QUT-Motorsport/QUTMS_Shutdown/hardware/CAD/219-3MSTR/219-3poles.stp

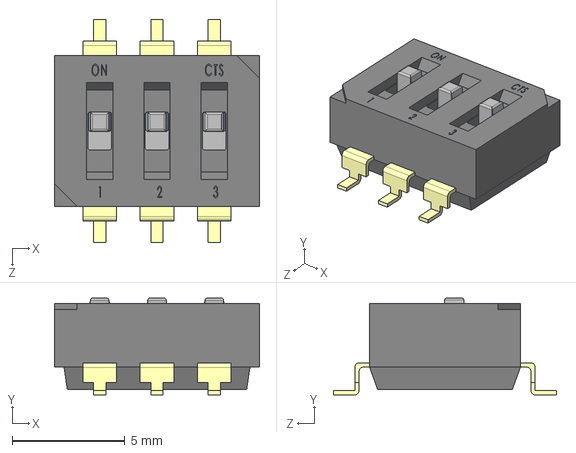
[picture p1: CAD file, 2021-01-13]
hardware/CAD/219-3MSTR/219-3poles.stp
9.09 x 4.30 x 9.91 mm
