QUT-Motorsport/QUTMS_Shutdown/hardware/CAD/6-Pin Header/pin_header_a-sl254-ea-z06mp1.stp

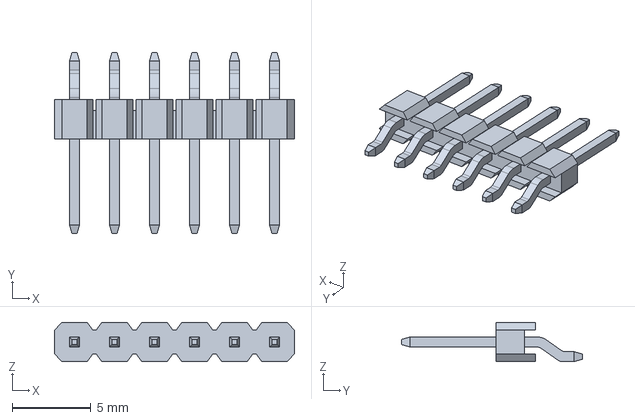
[picture p2: CAD file, 2021-01-13]
hardware/CAD/6-Pin Header/pin_header_a-sl254-ea-z06mp1.stp
15.2 x 11.5 x 2.50 mm
