QUT-Motorsport/QUTMS_Shutdown/hardware/CAD/CVS-03TB/CVS-03TB.stp

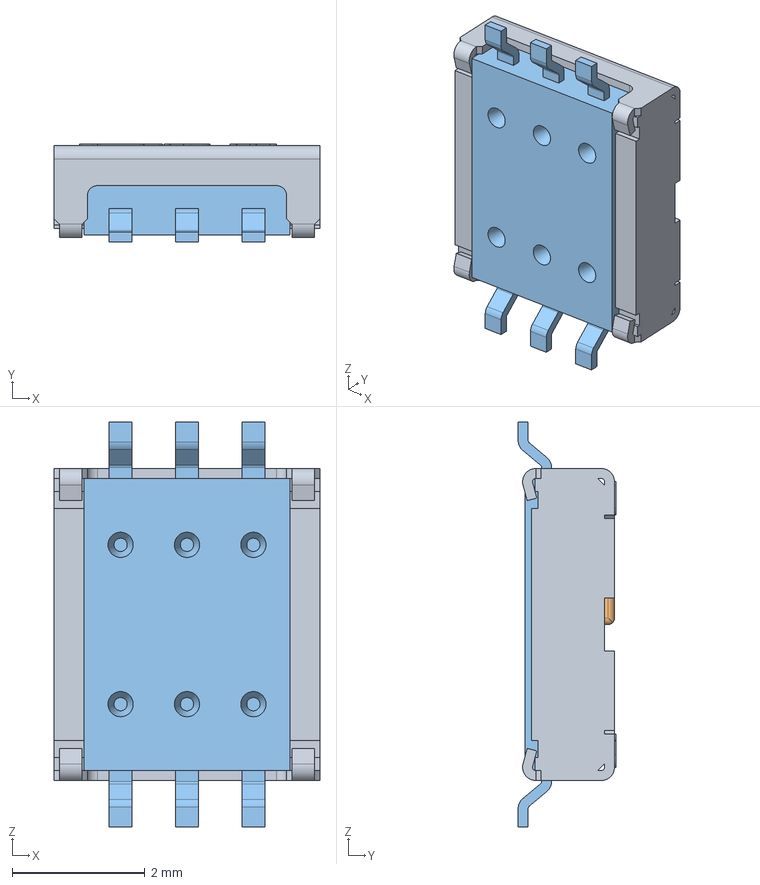
[picture p3: CAD file, 2021-01-13]
hardware/CAD/CVS-03TB/CVS-03TB.stp
4.00 x 1.47 x 6.10 mm
_CVS-03-body
_CVS-slider x 3
_CVS-B4-terminal
