QUT-Motorsport/QUTMS_Shutdown/hardware/CAD/LY4-0-DC12/LY4.SLDPRT

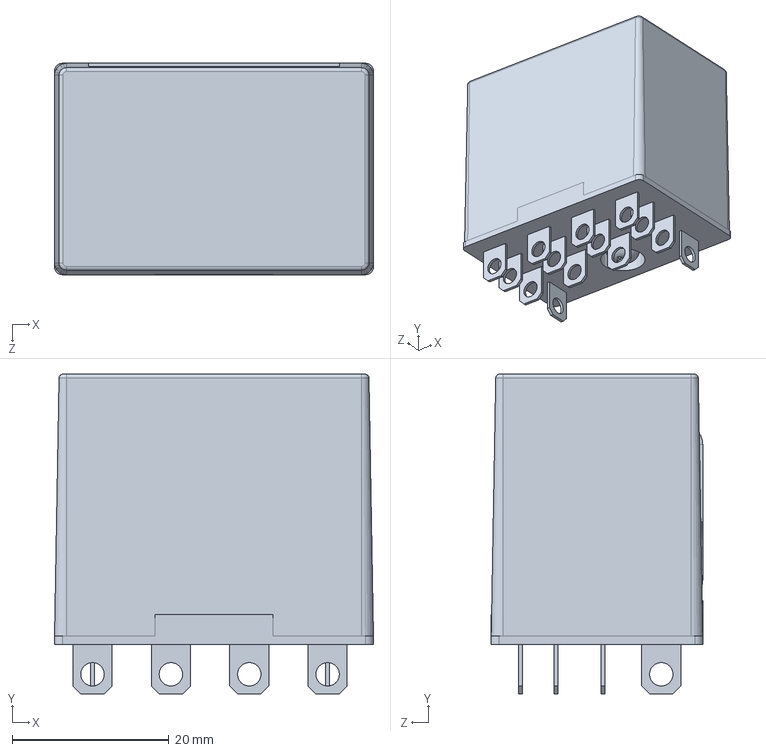
[picture p4: CAD file, 2021-01-13]
hardware/CAD/LY4-0-DC12/LY4.SLDPRT
40.7 x 40.8 x 27.0 mm
