QUT-Motorsport/QUTMS_Shutdown/hardware/CAD/MX120G/143626.stp

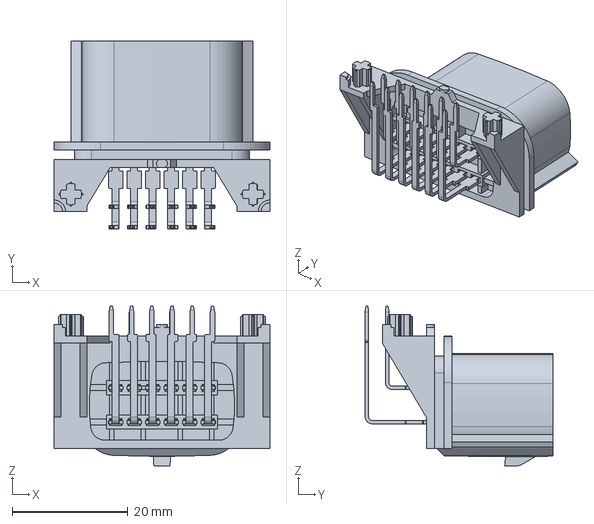
[picture p5: CAD file, 2021-01-13]
hardware/CAD/MX120G/143626.stp
37.4 x 32.5 x 27.6 mm
