QUT-Motorsport/QUTMS_Shutdown/hardware/QUTMS-SHDN-V00/QUTMS-SHDN-V00.pdf

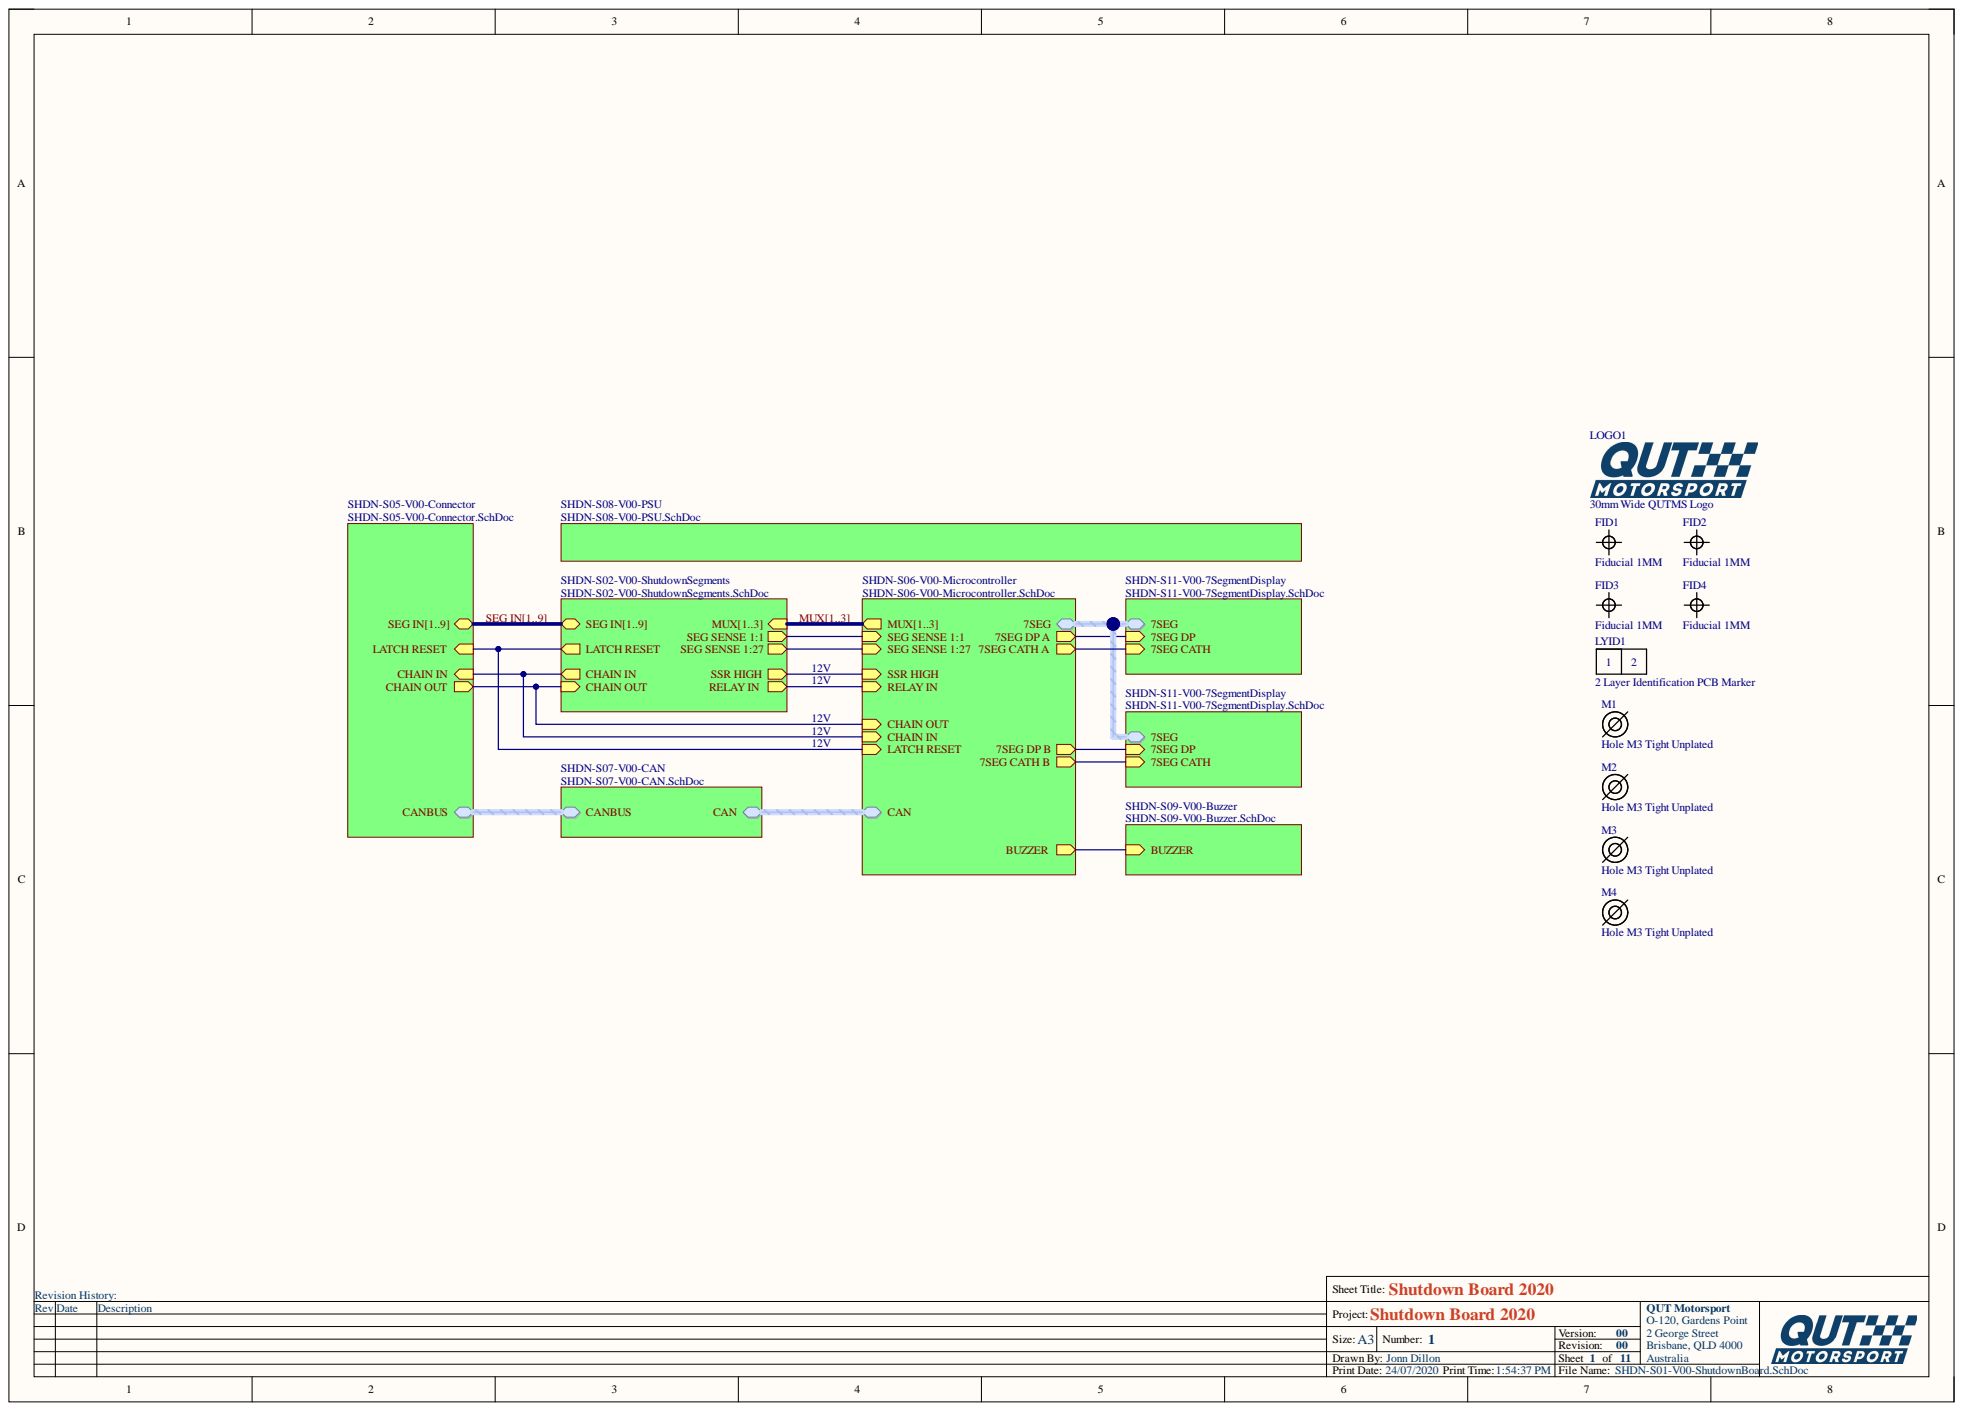
[picture p10: page 1]

C H A IN O UT R E LAY I N | 12V

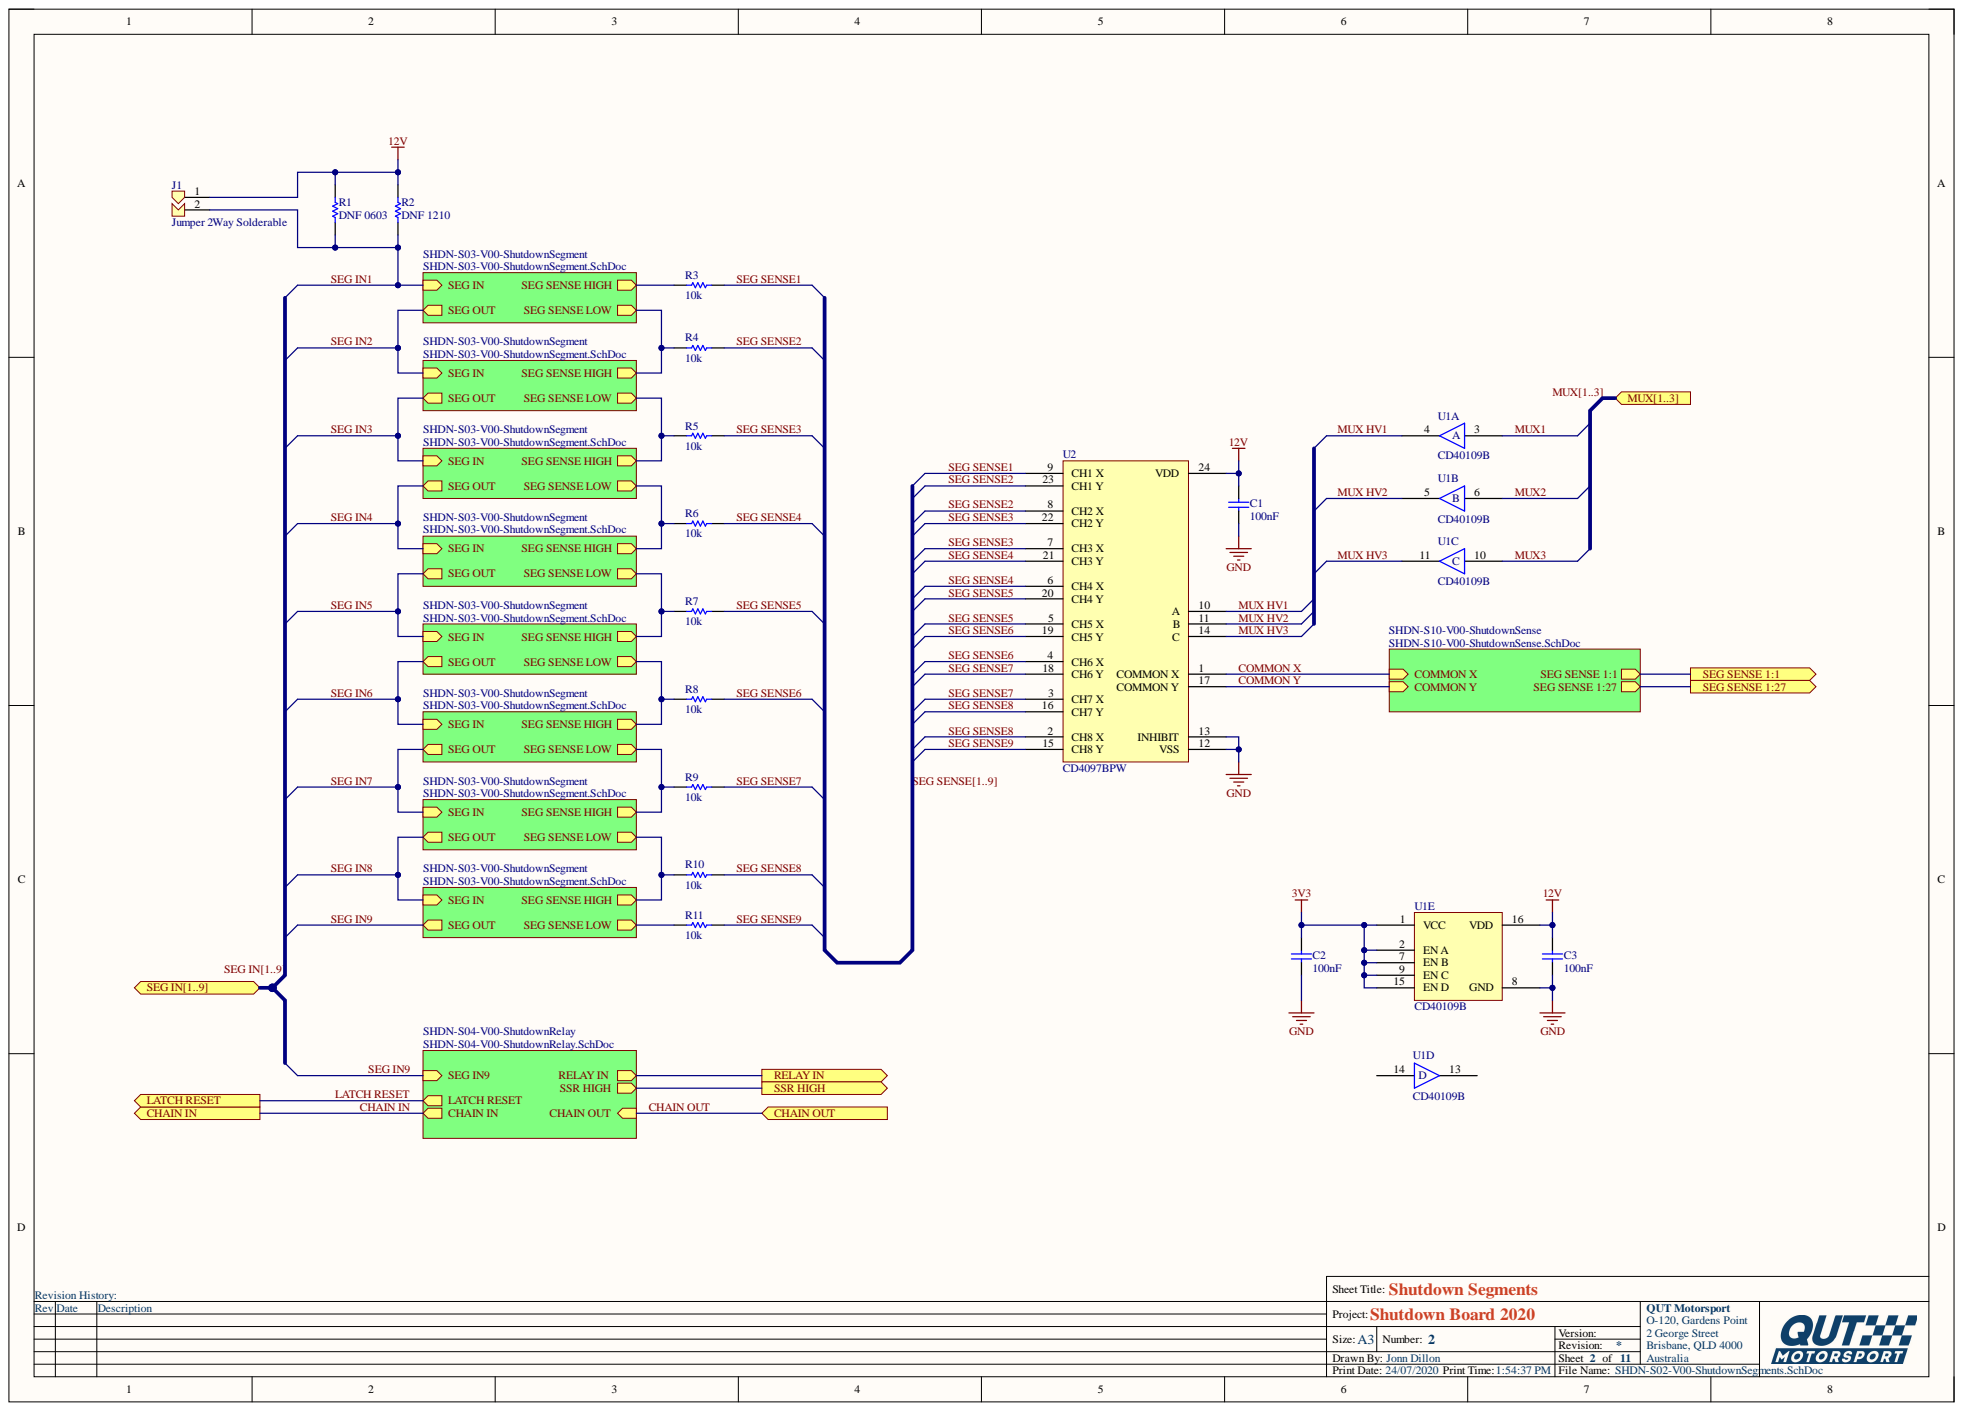
[picture p11: page 2]

Sheet Title: Shutdown Segments
Shutdown Board 2020

Drawn By: Jonn Dillon

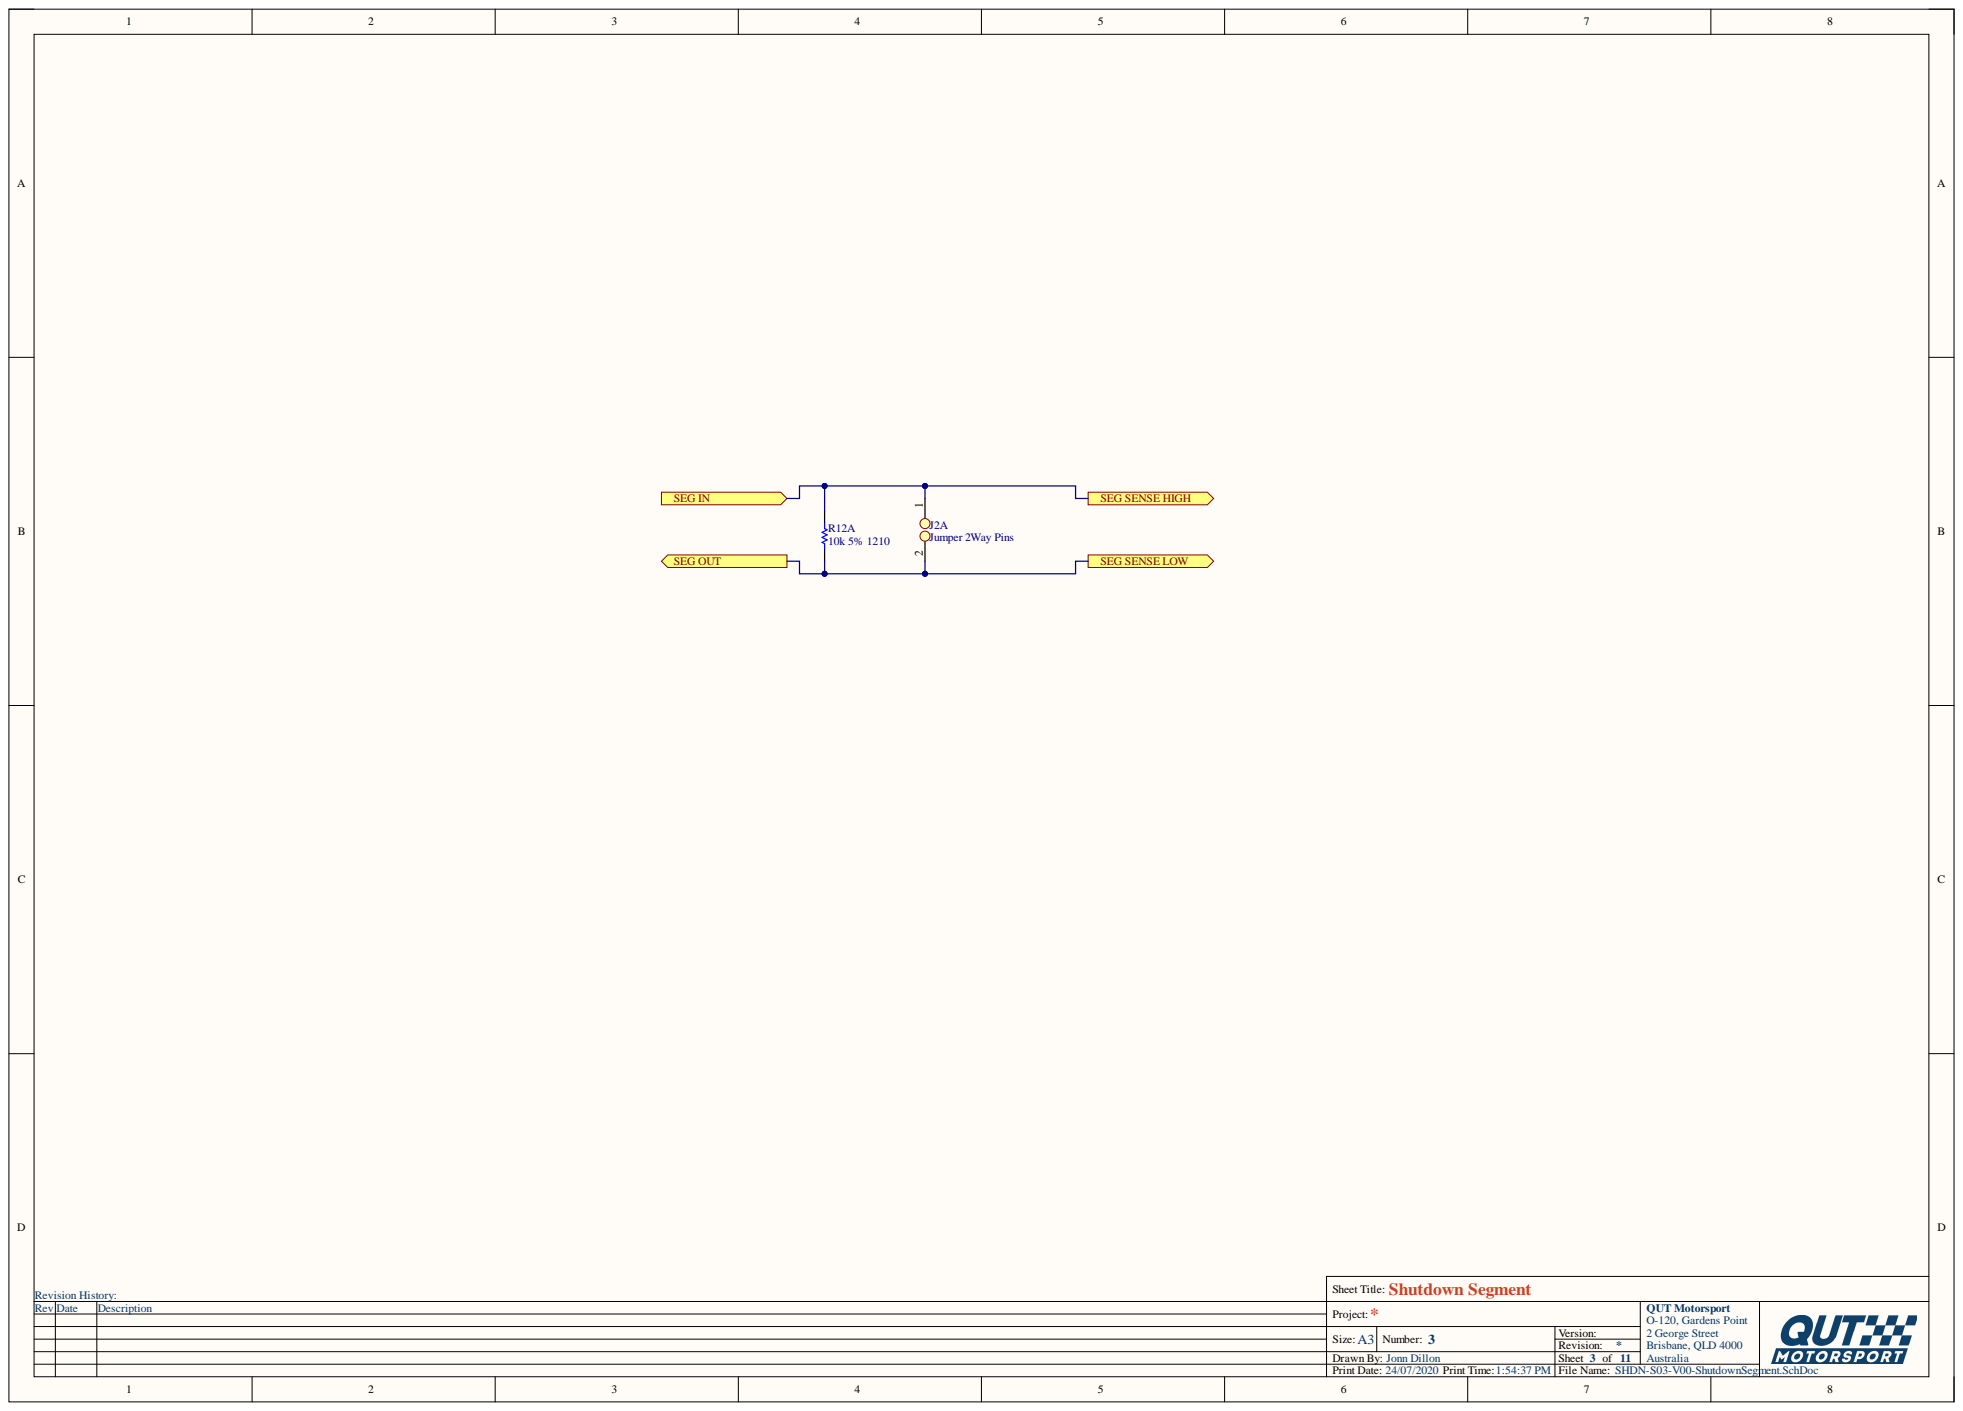
[picture p12: page 3]

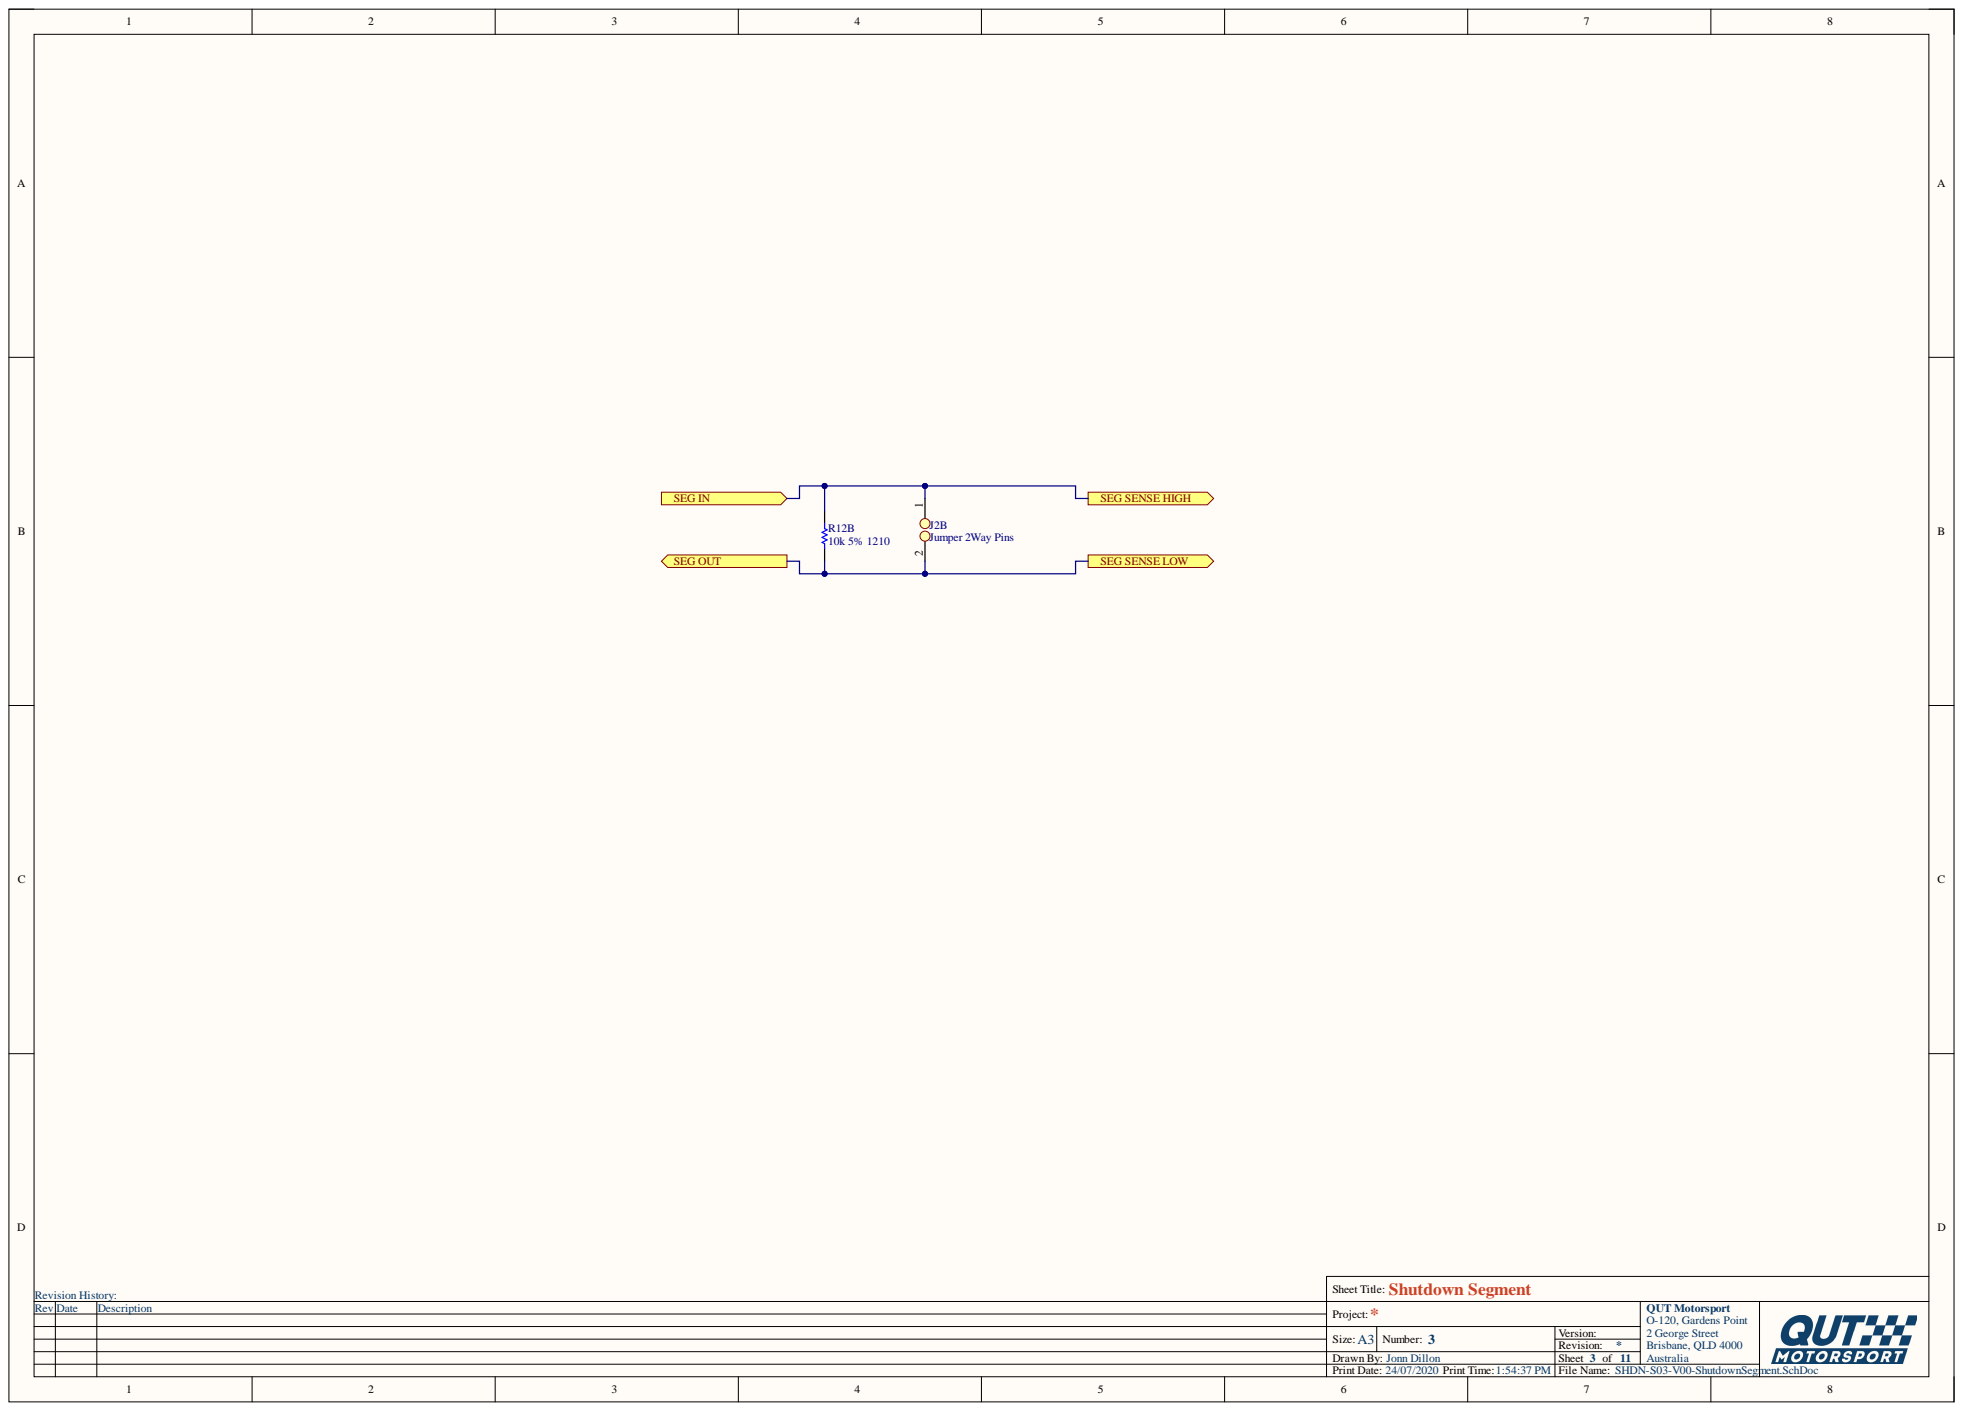
[picture p13: page 4]

Sheet Title: Shutdown Segment

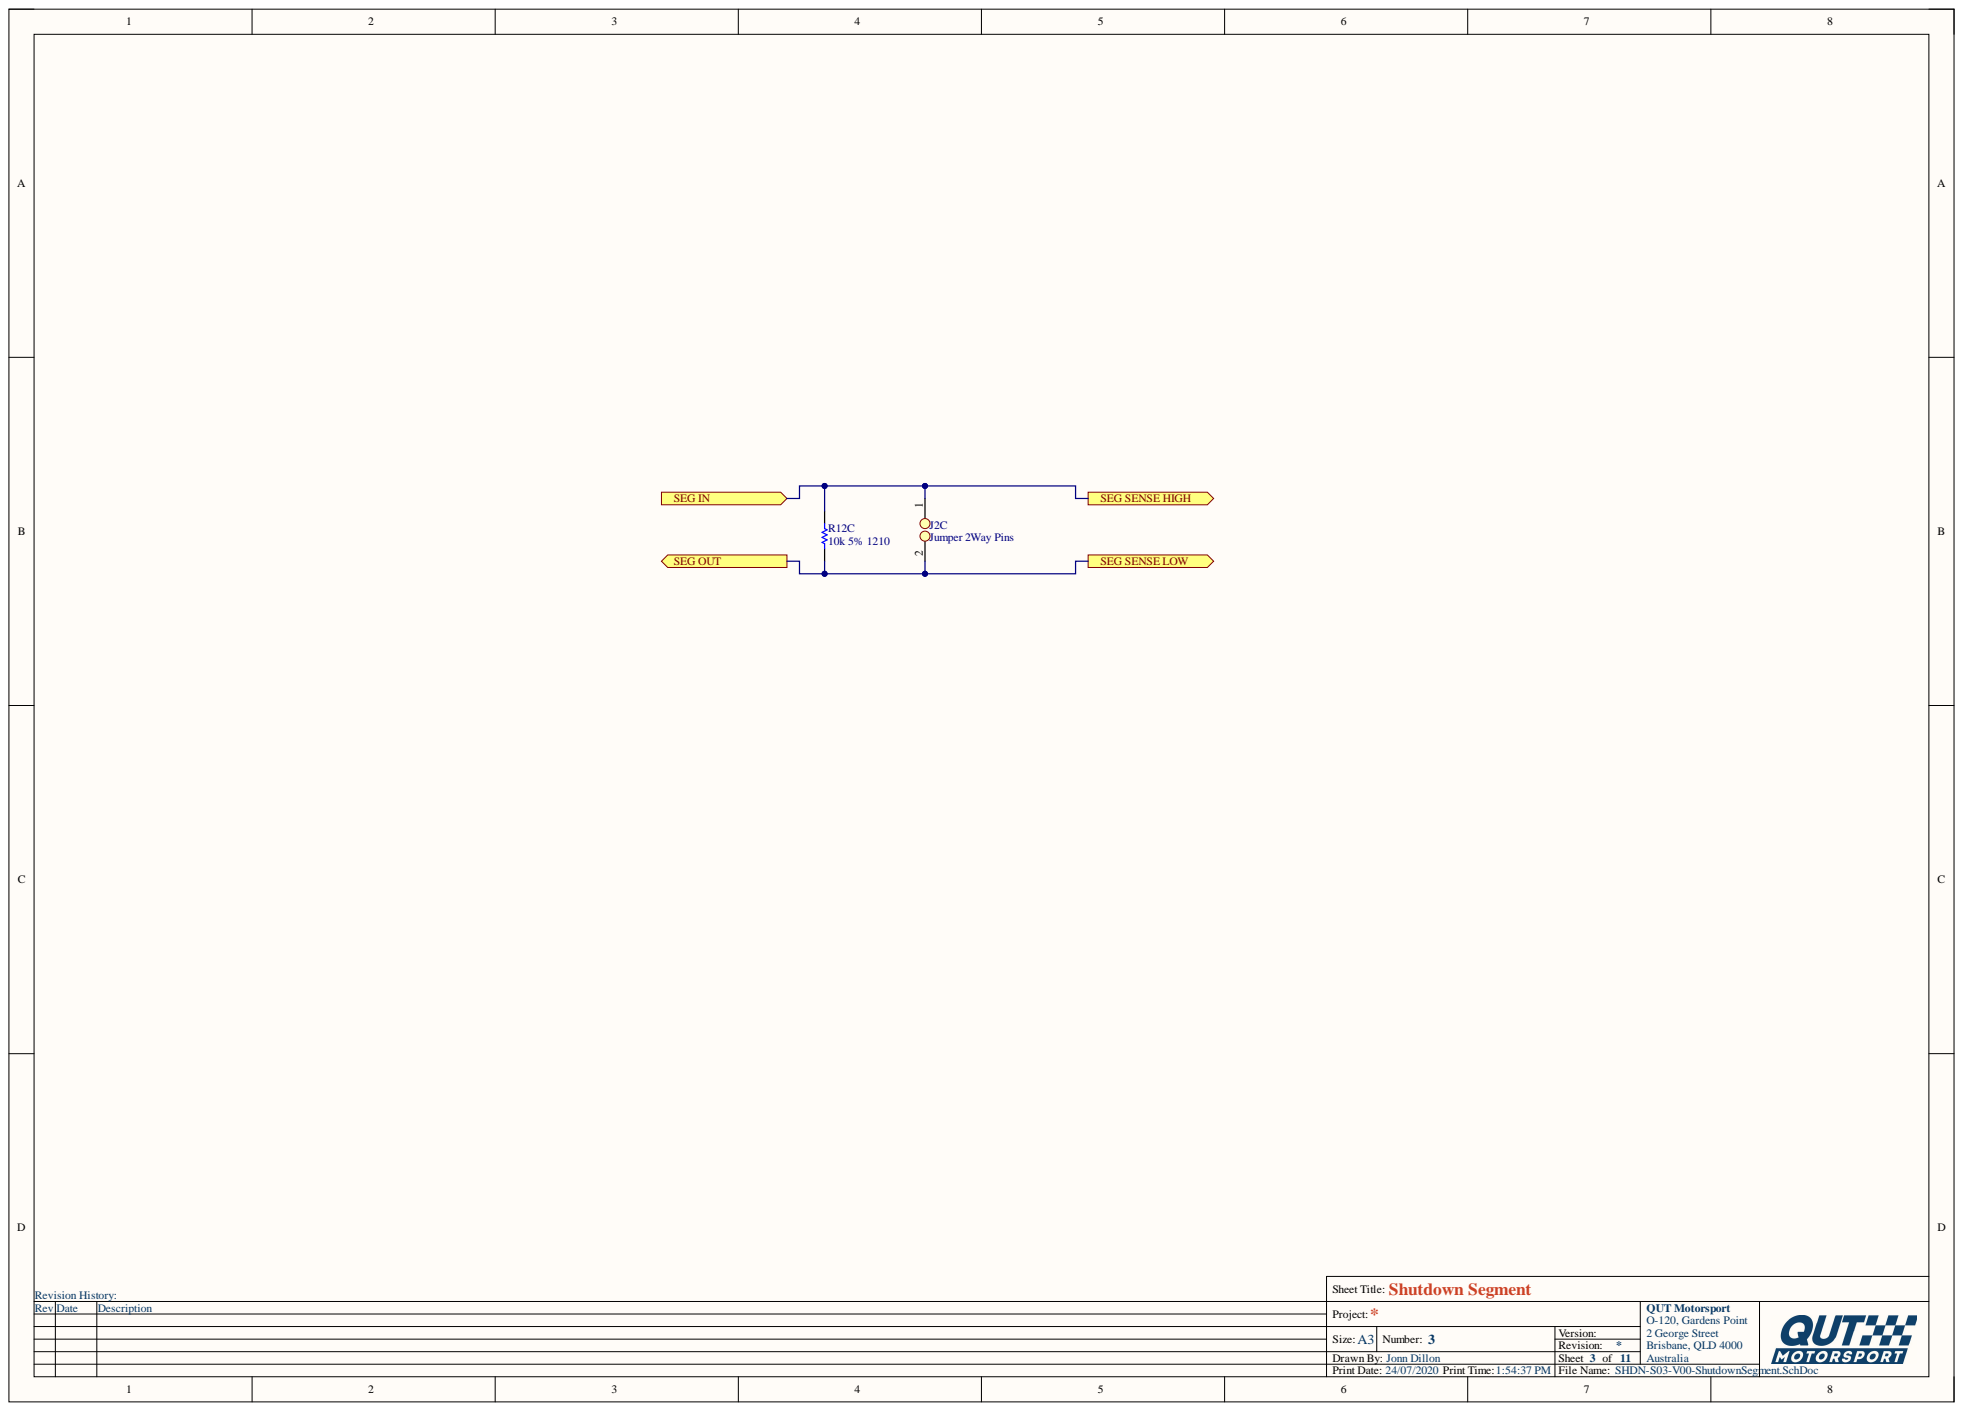
[picture p14: page 5]

Sheet Title: Shutdown Segment

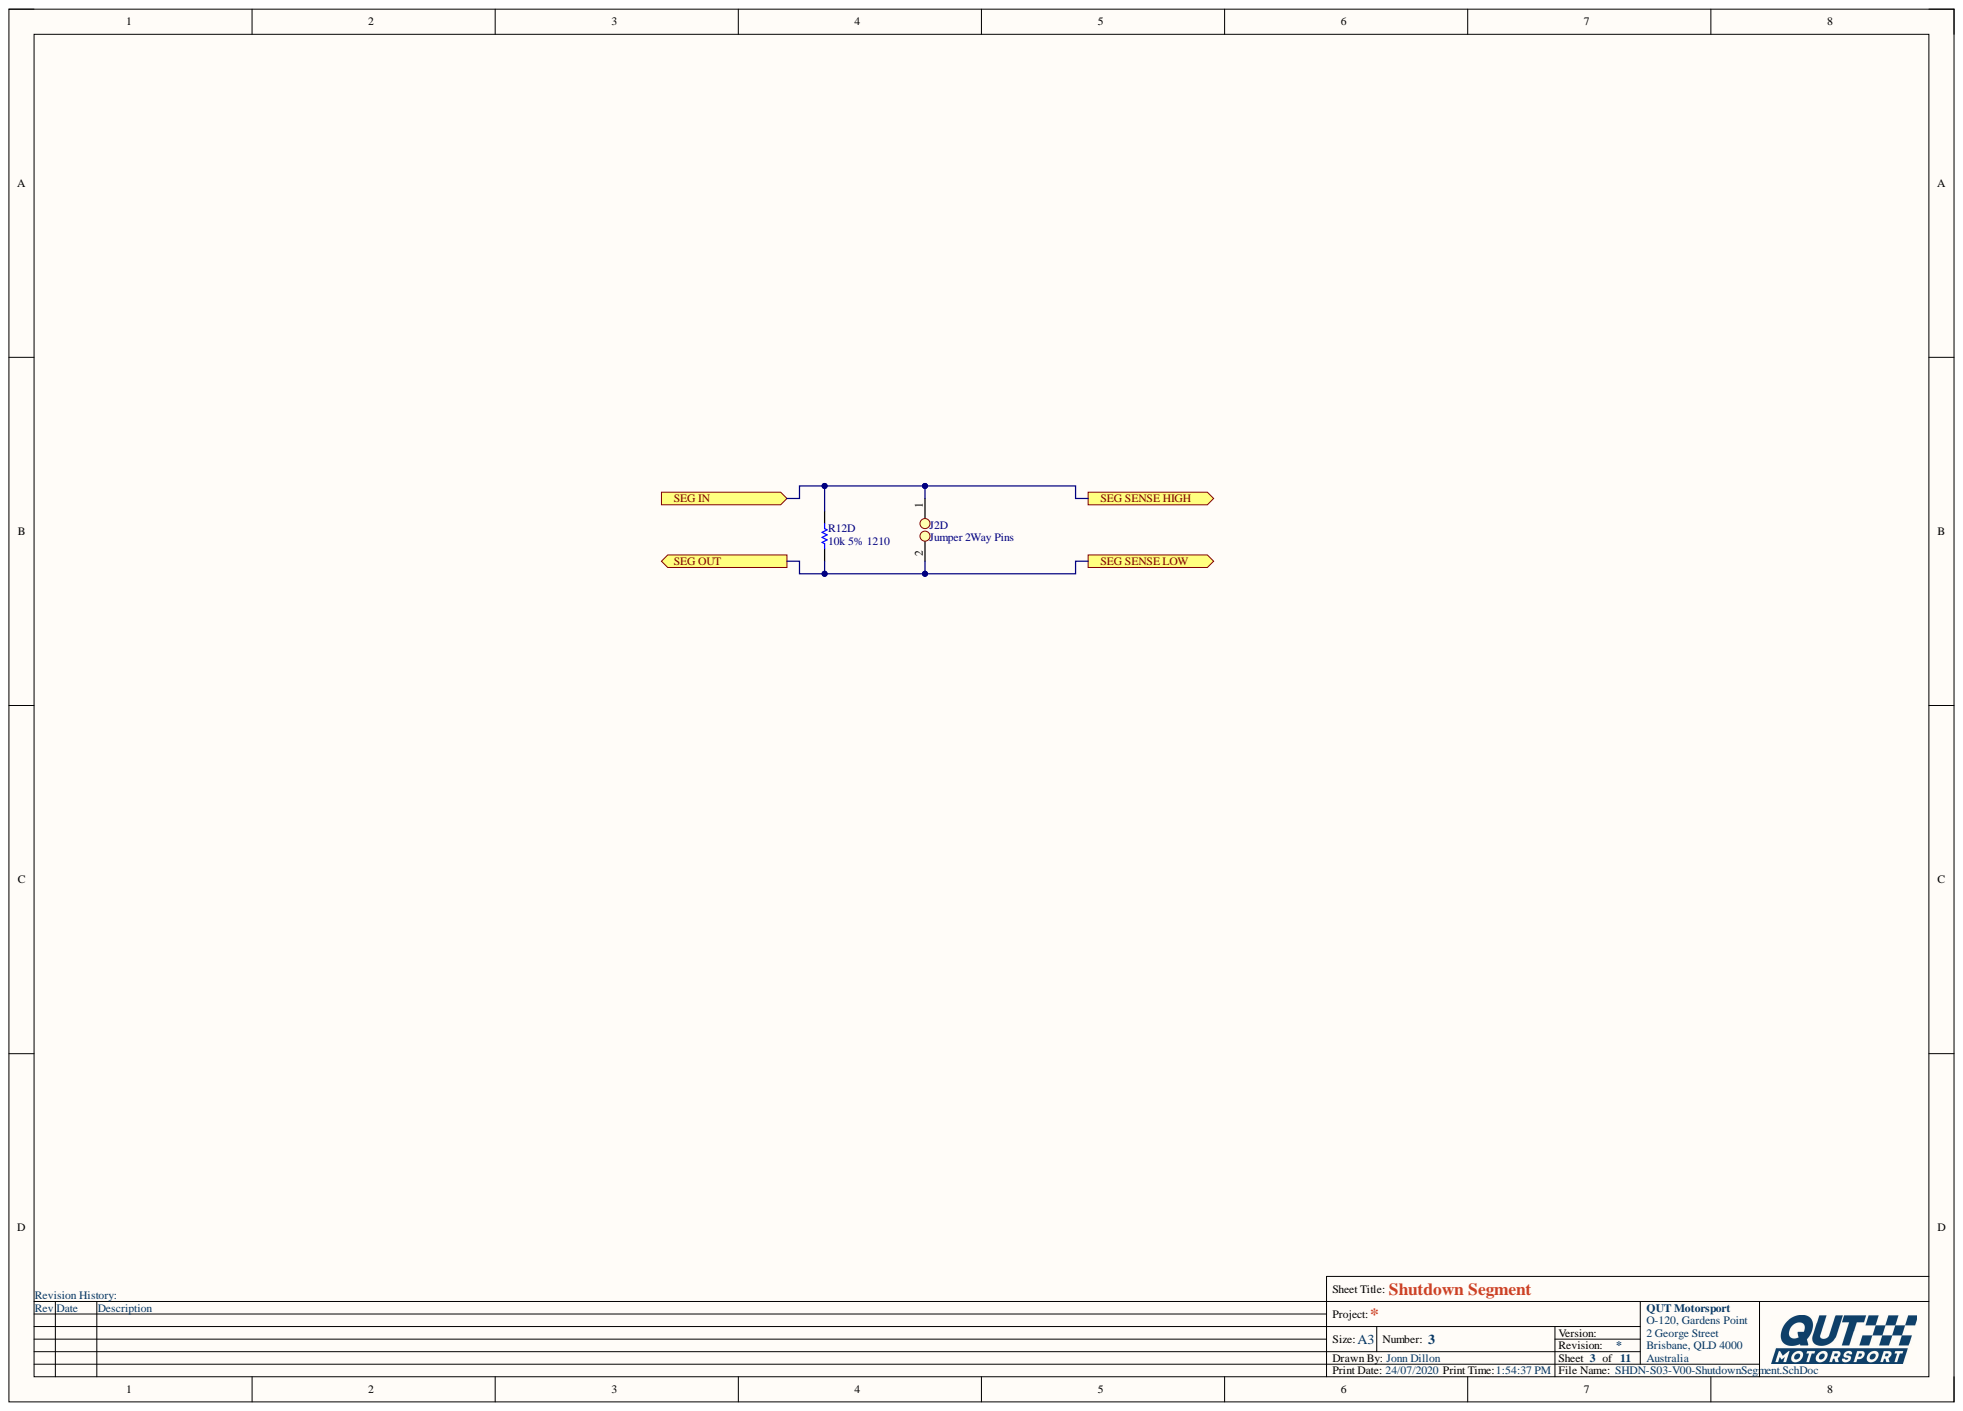
[picture p15: page 6]

Sheet Title: Shutdown Segment

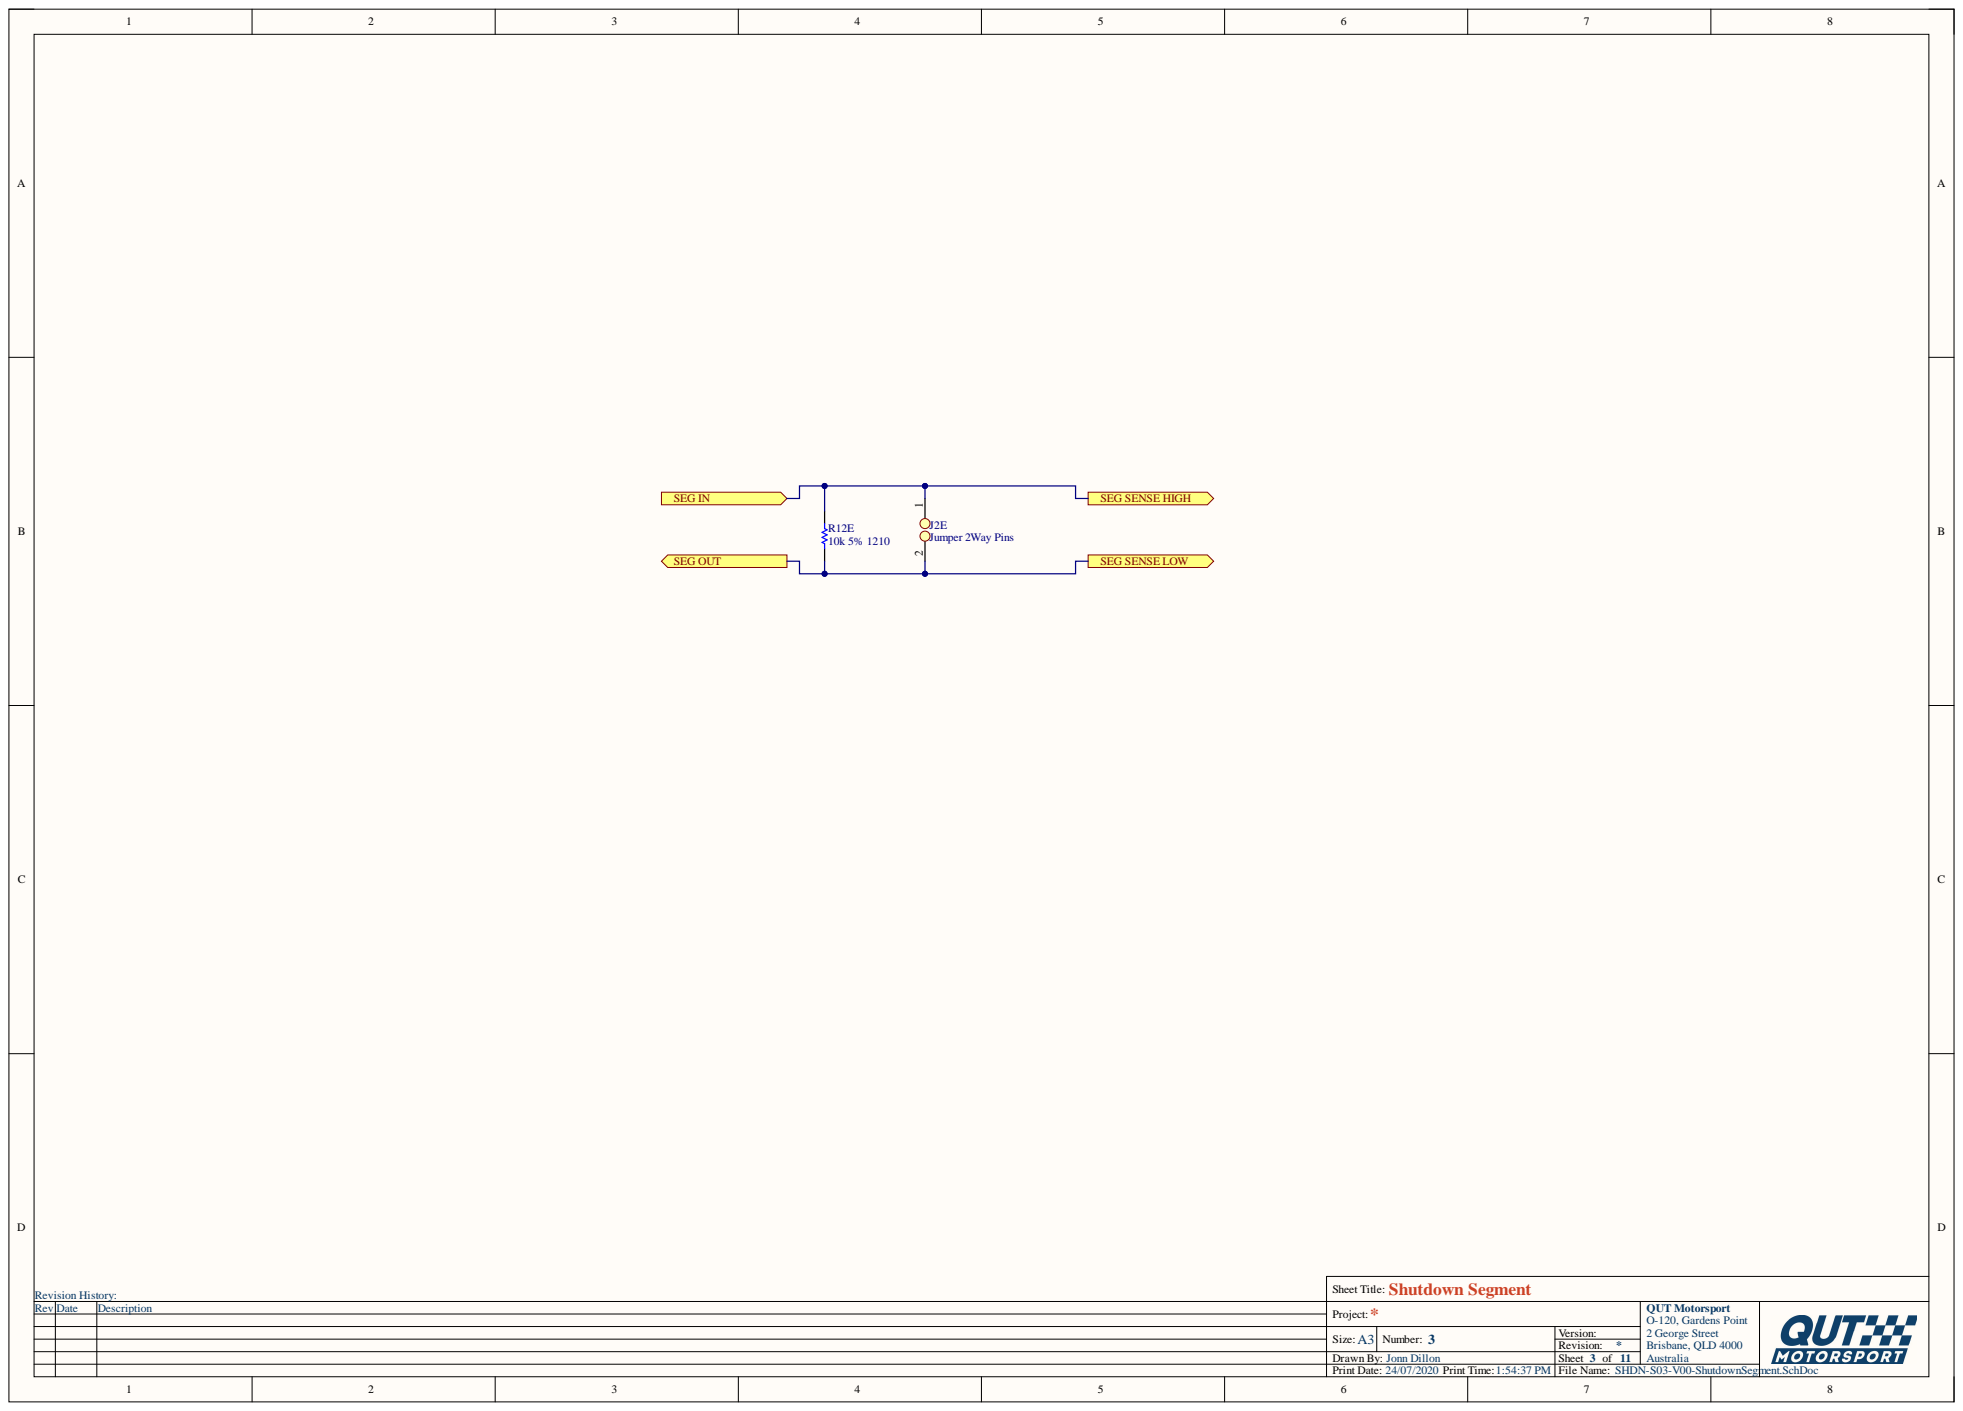
[picture p16: page 7]

Sheet Title: Shutdown Segment

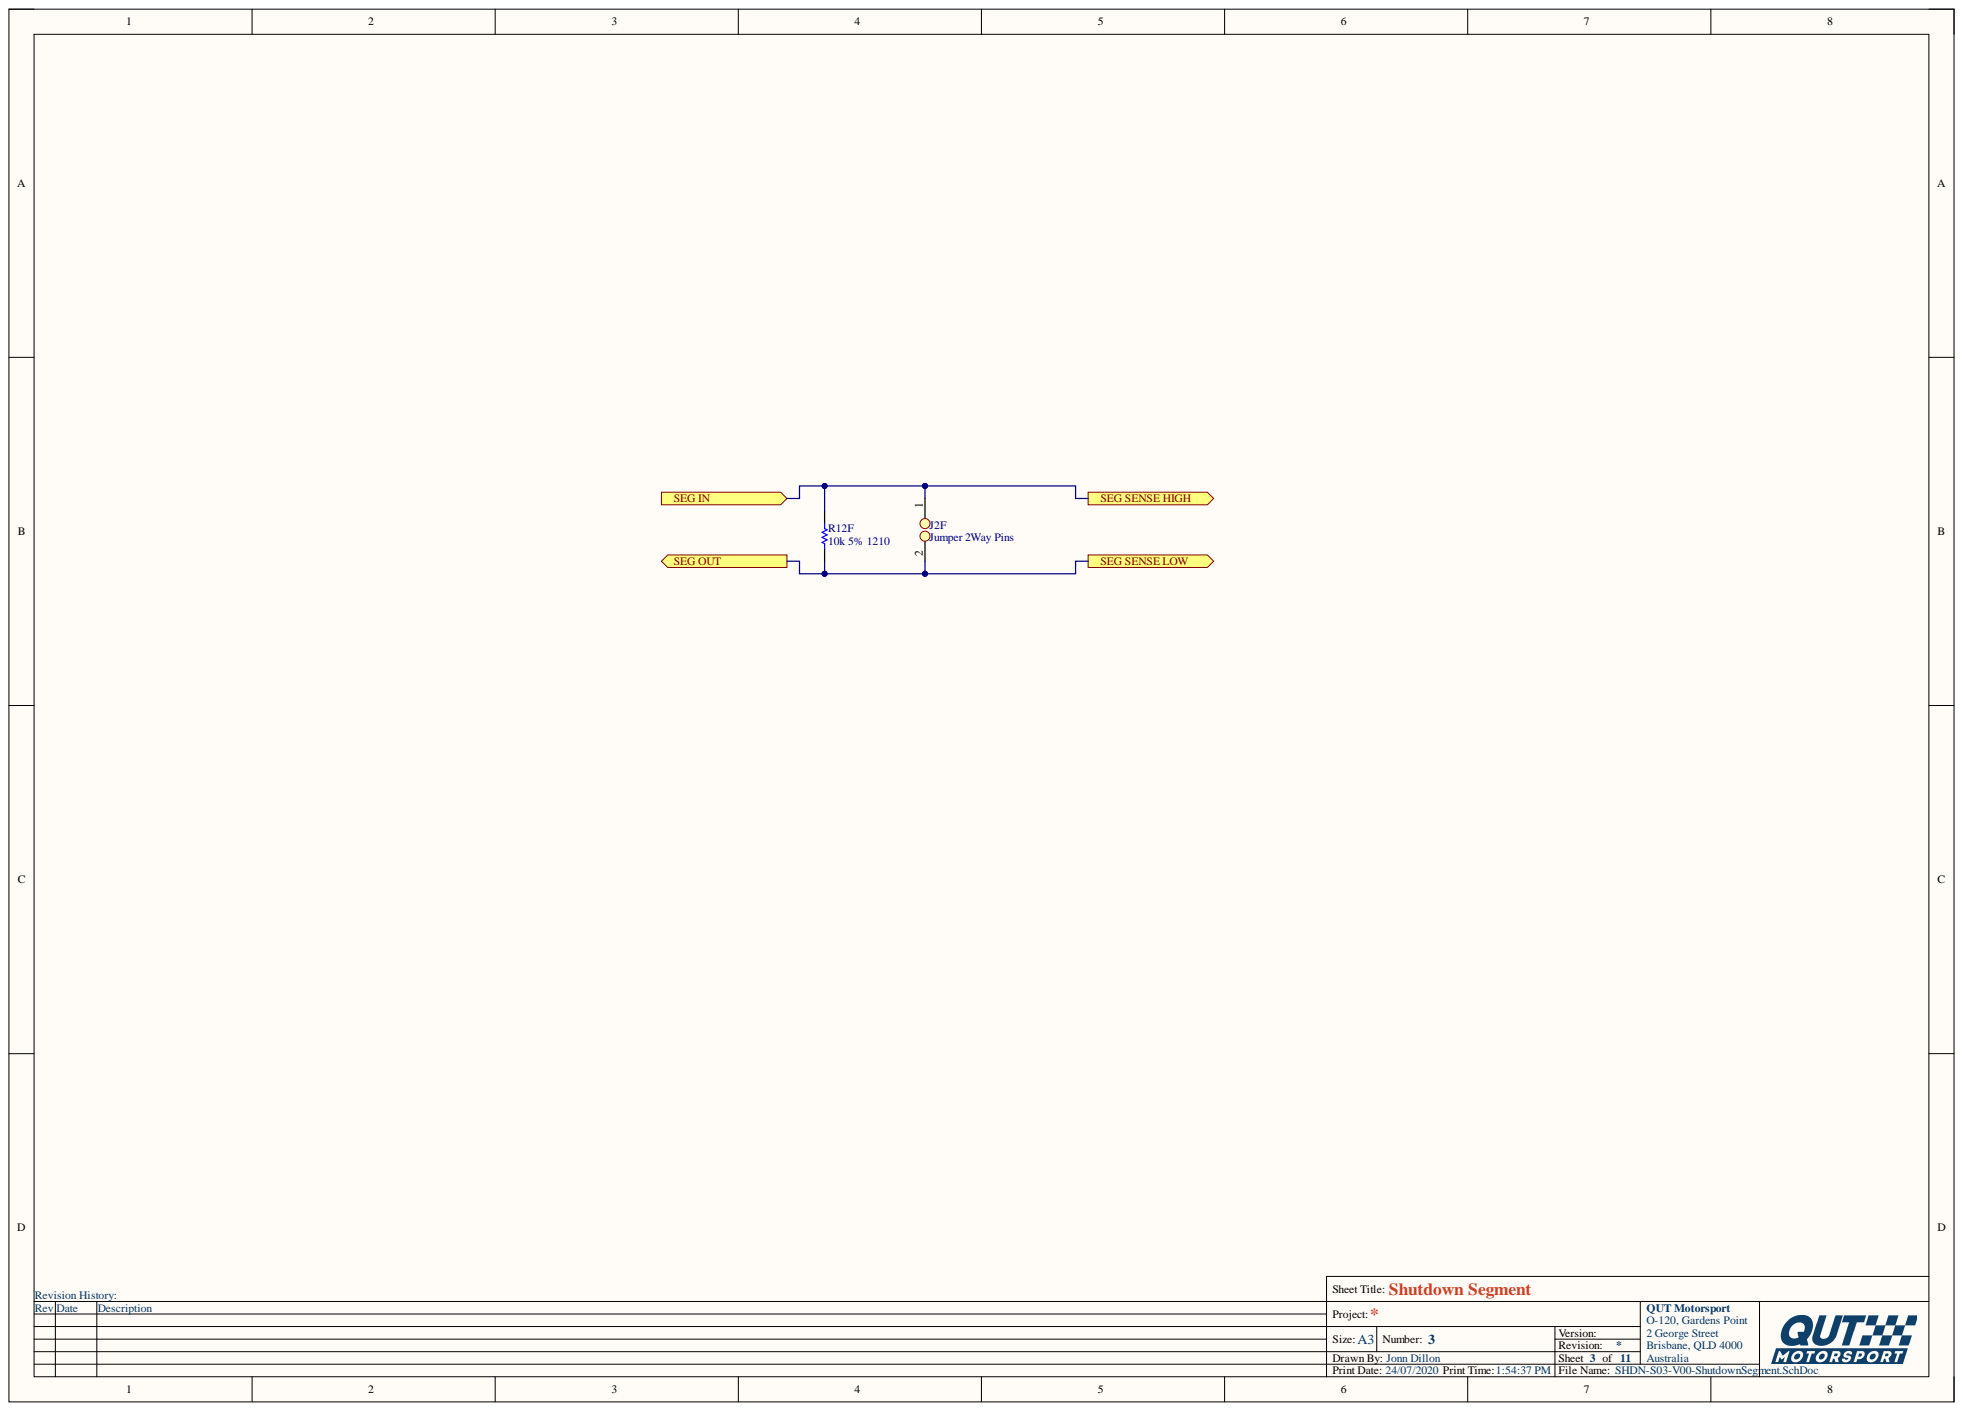
[picture p17: page 8]

Sheet Title: Shutdown Segment

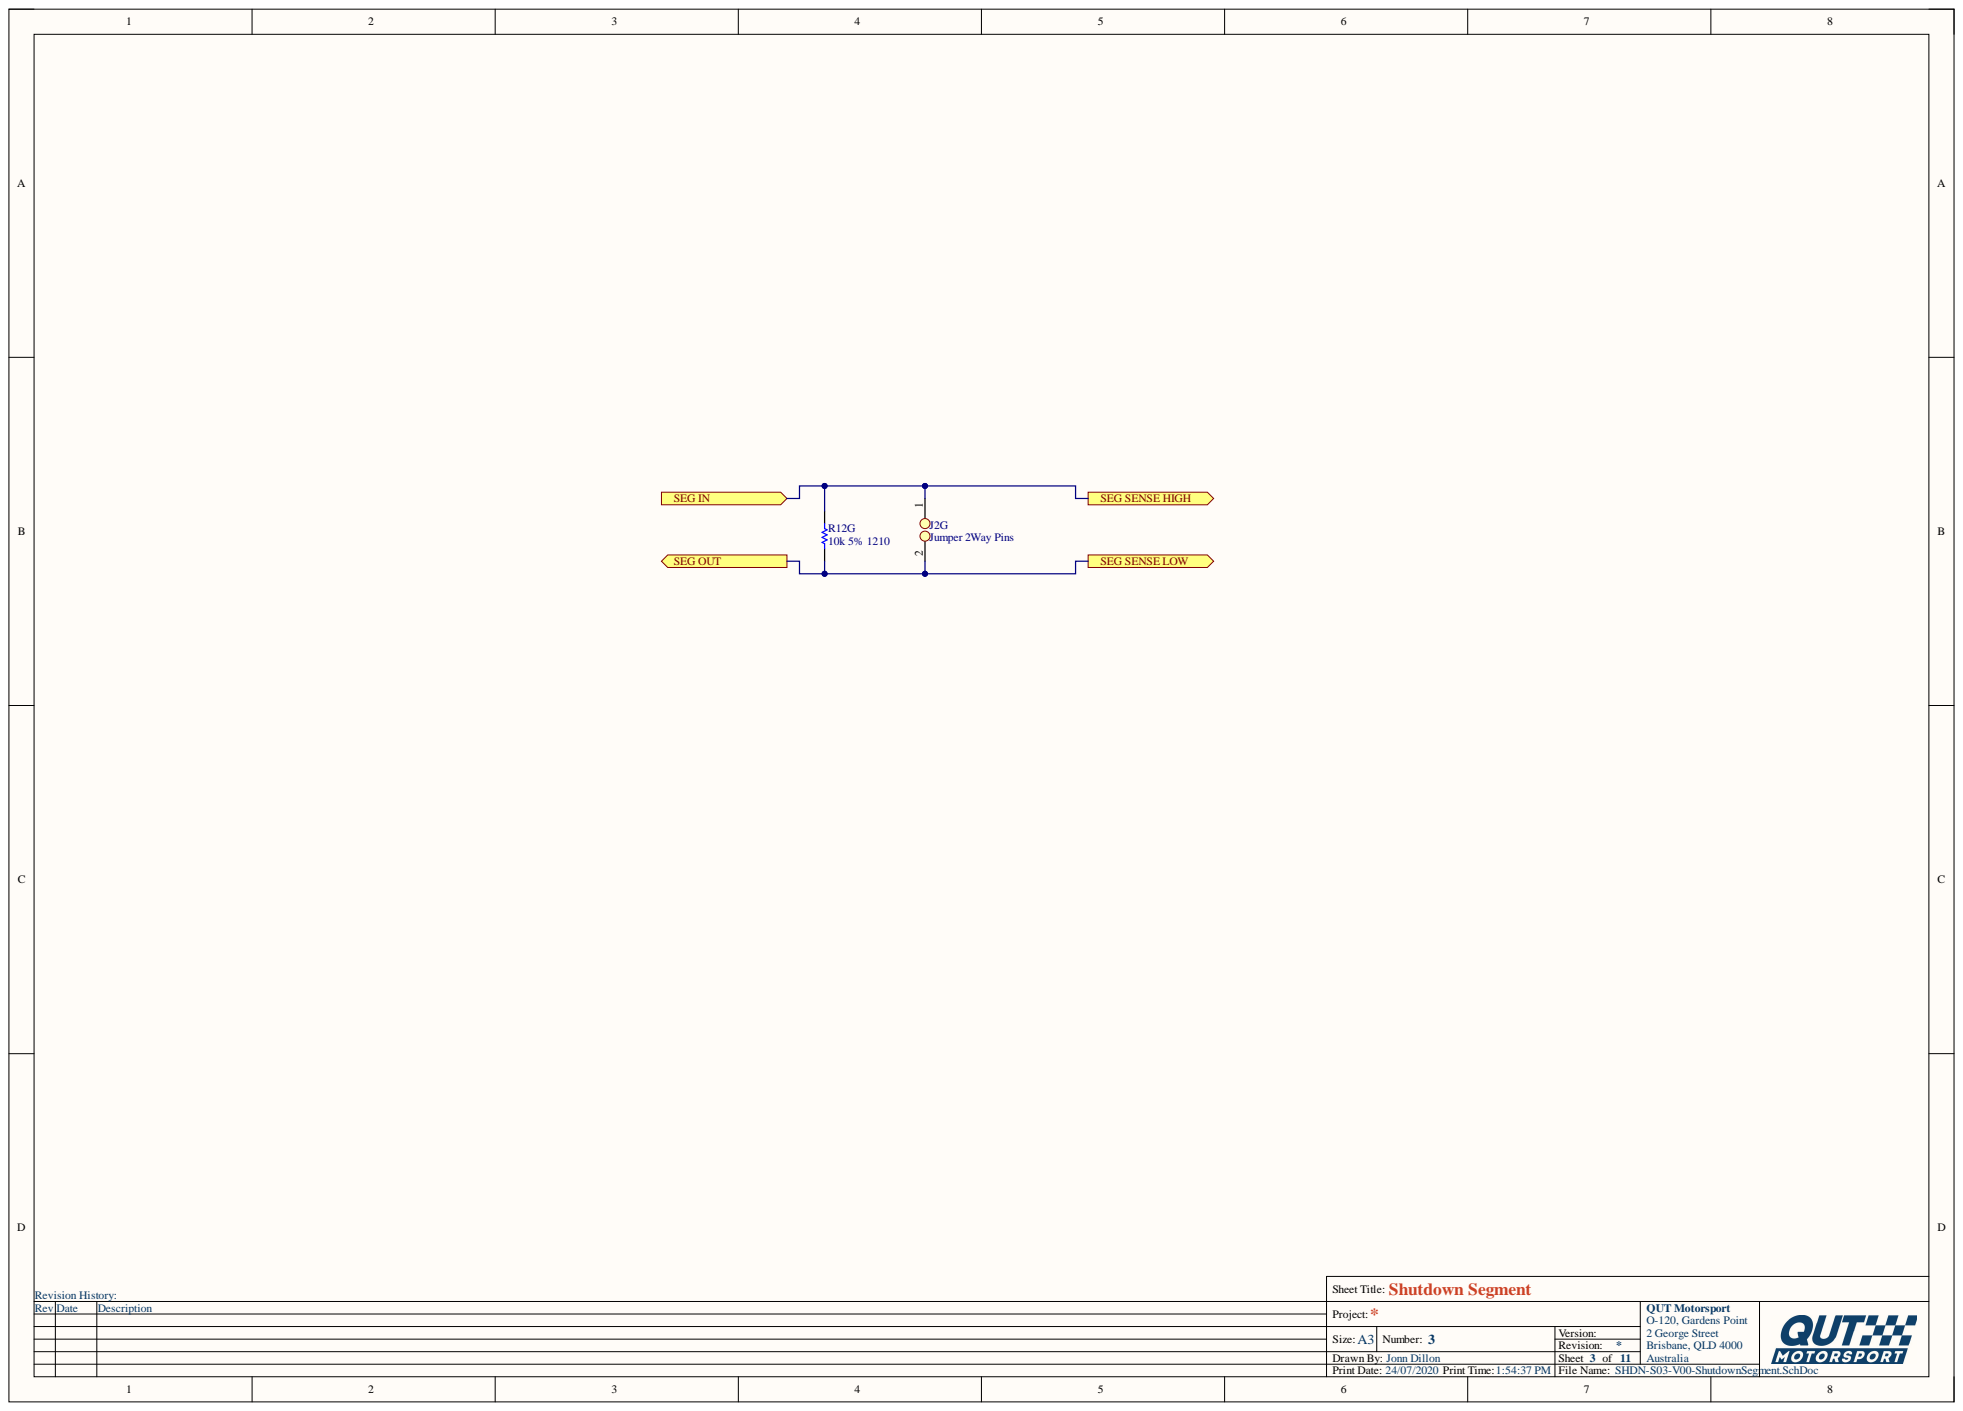
[picture p18: page 9]

Sheet Title: Shutdown Segment

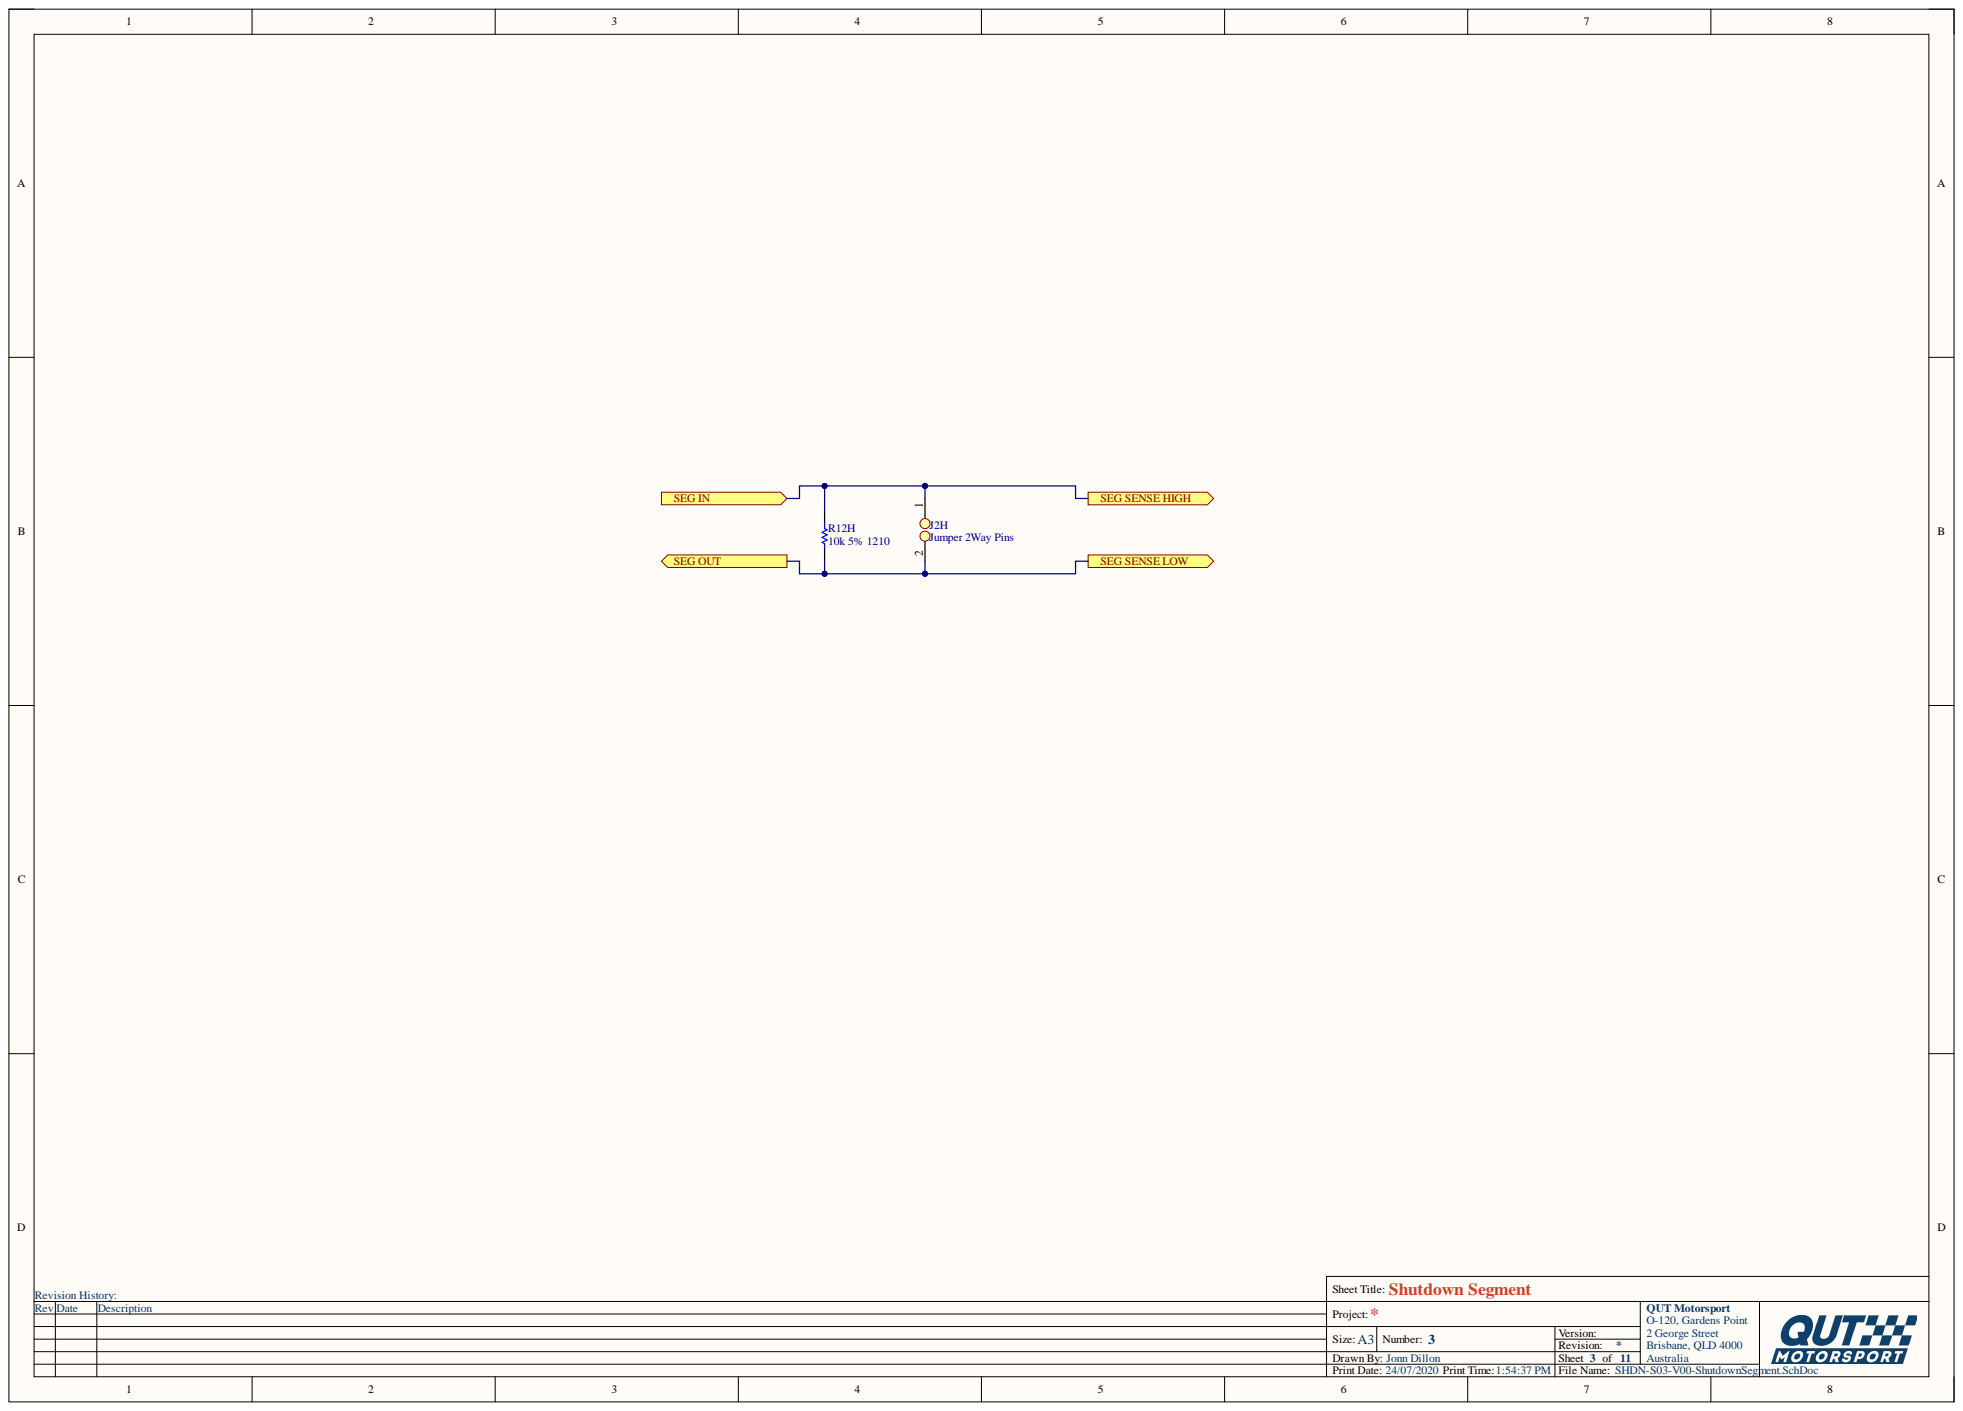
[picture p19: page 10]

Sheet Title: Shutdown Segment

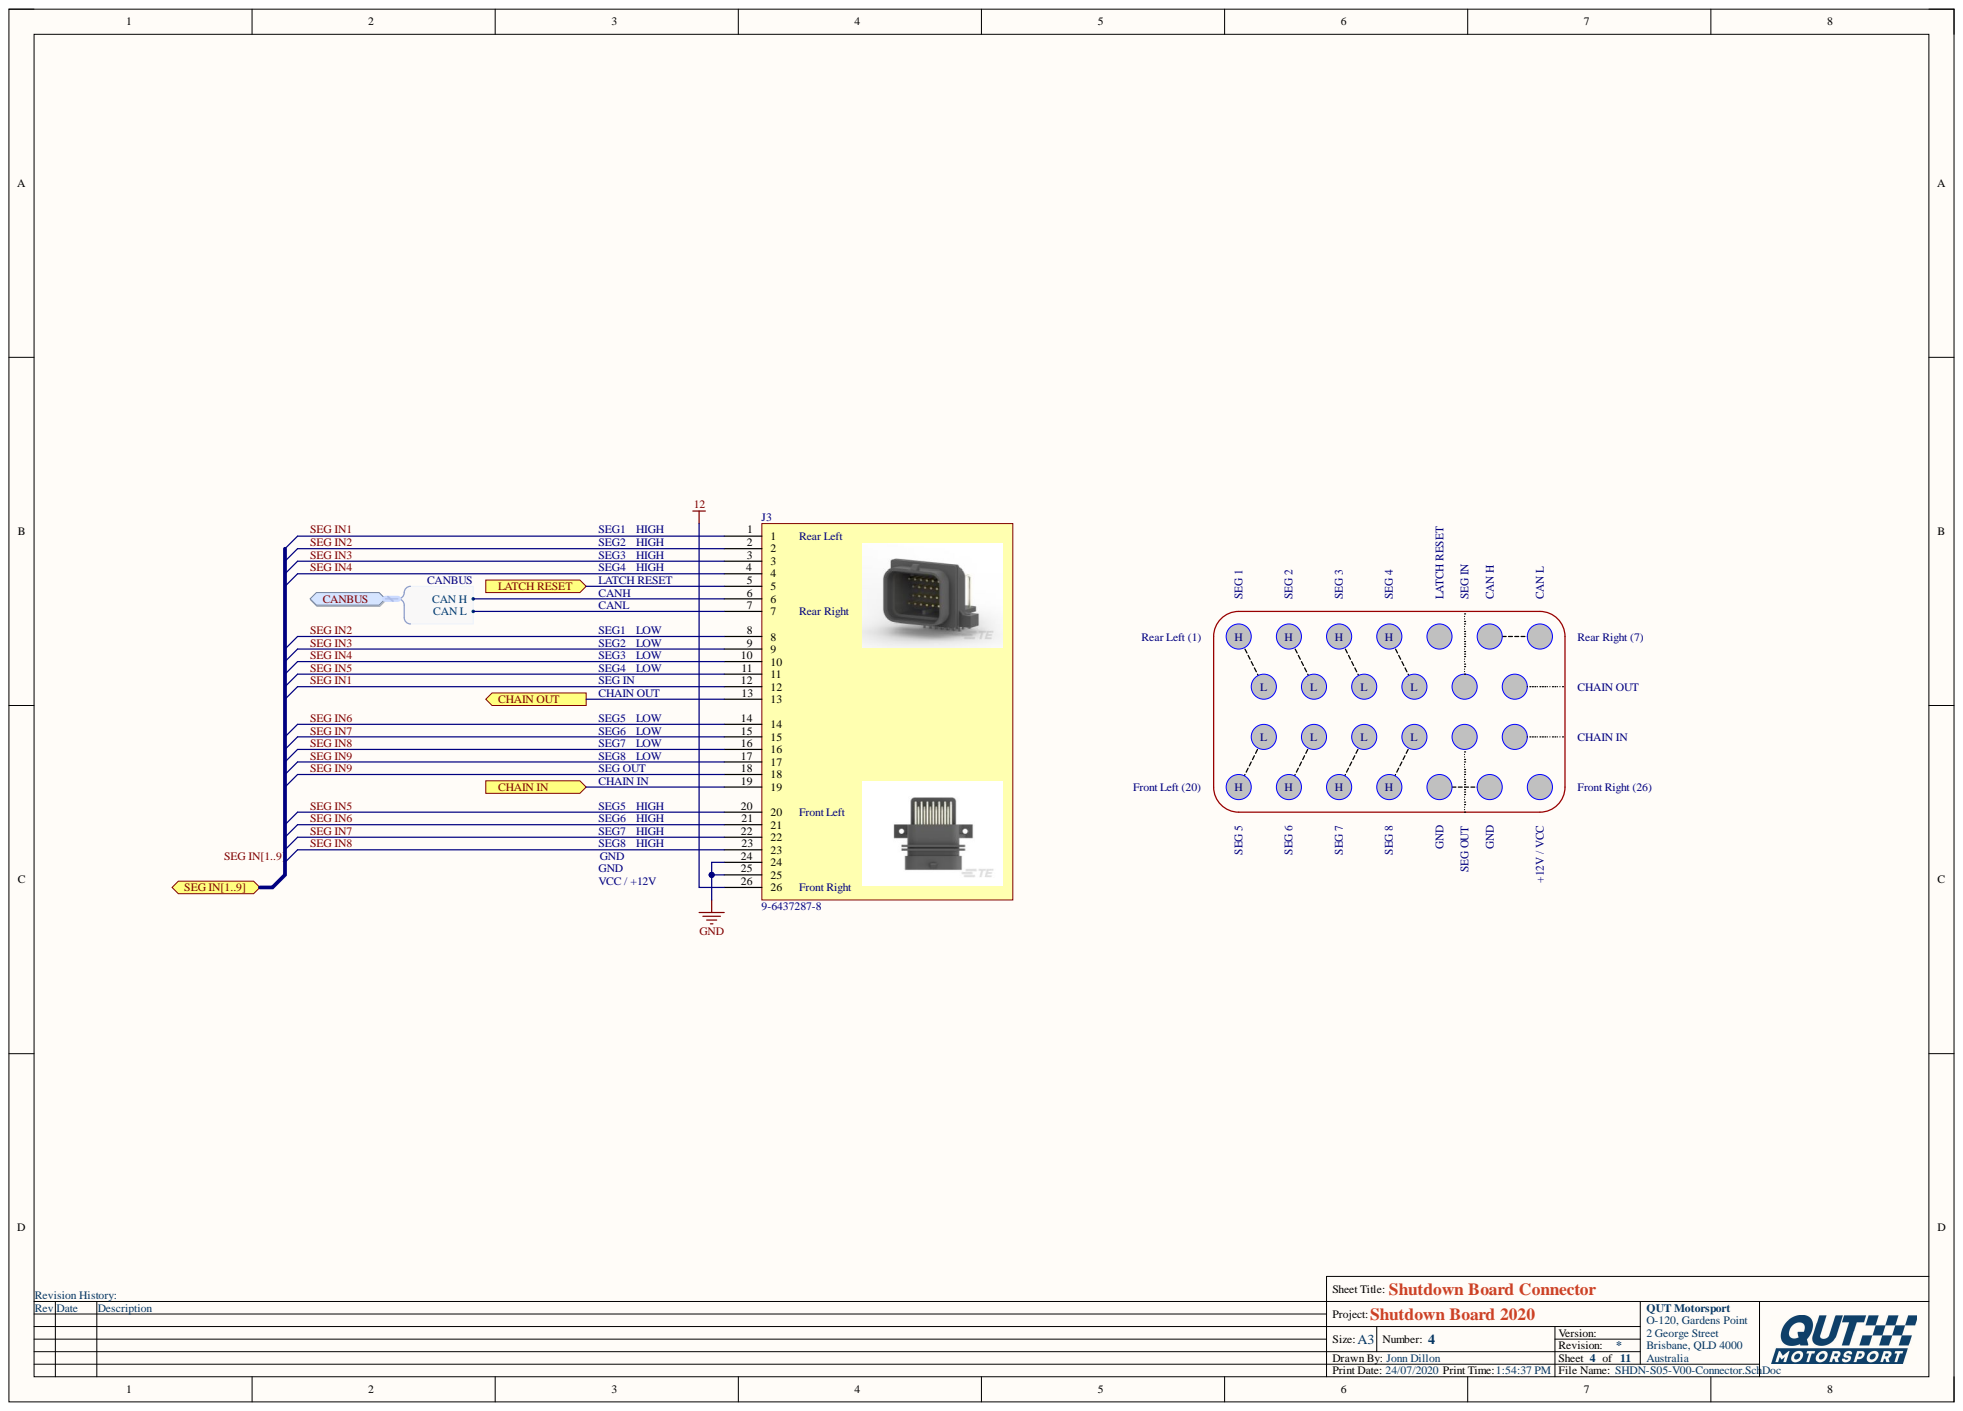
[picture p20: page 11]

25 25
26 26

Sheet Title: Shutdown Board Connector
Shutdown Board 2020

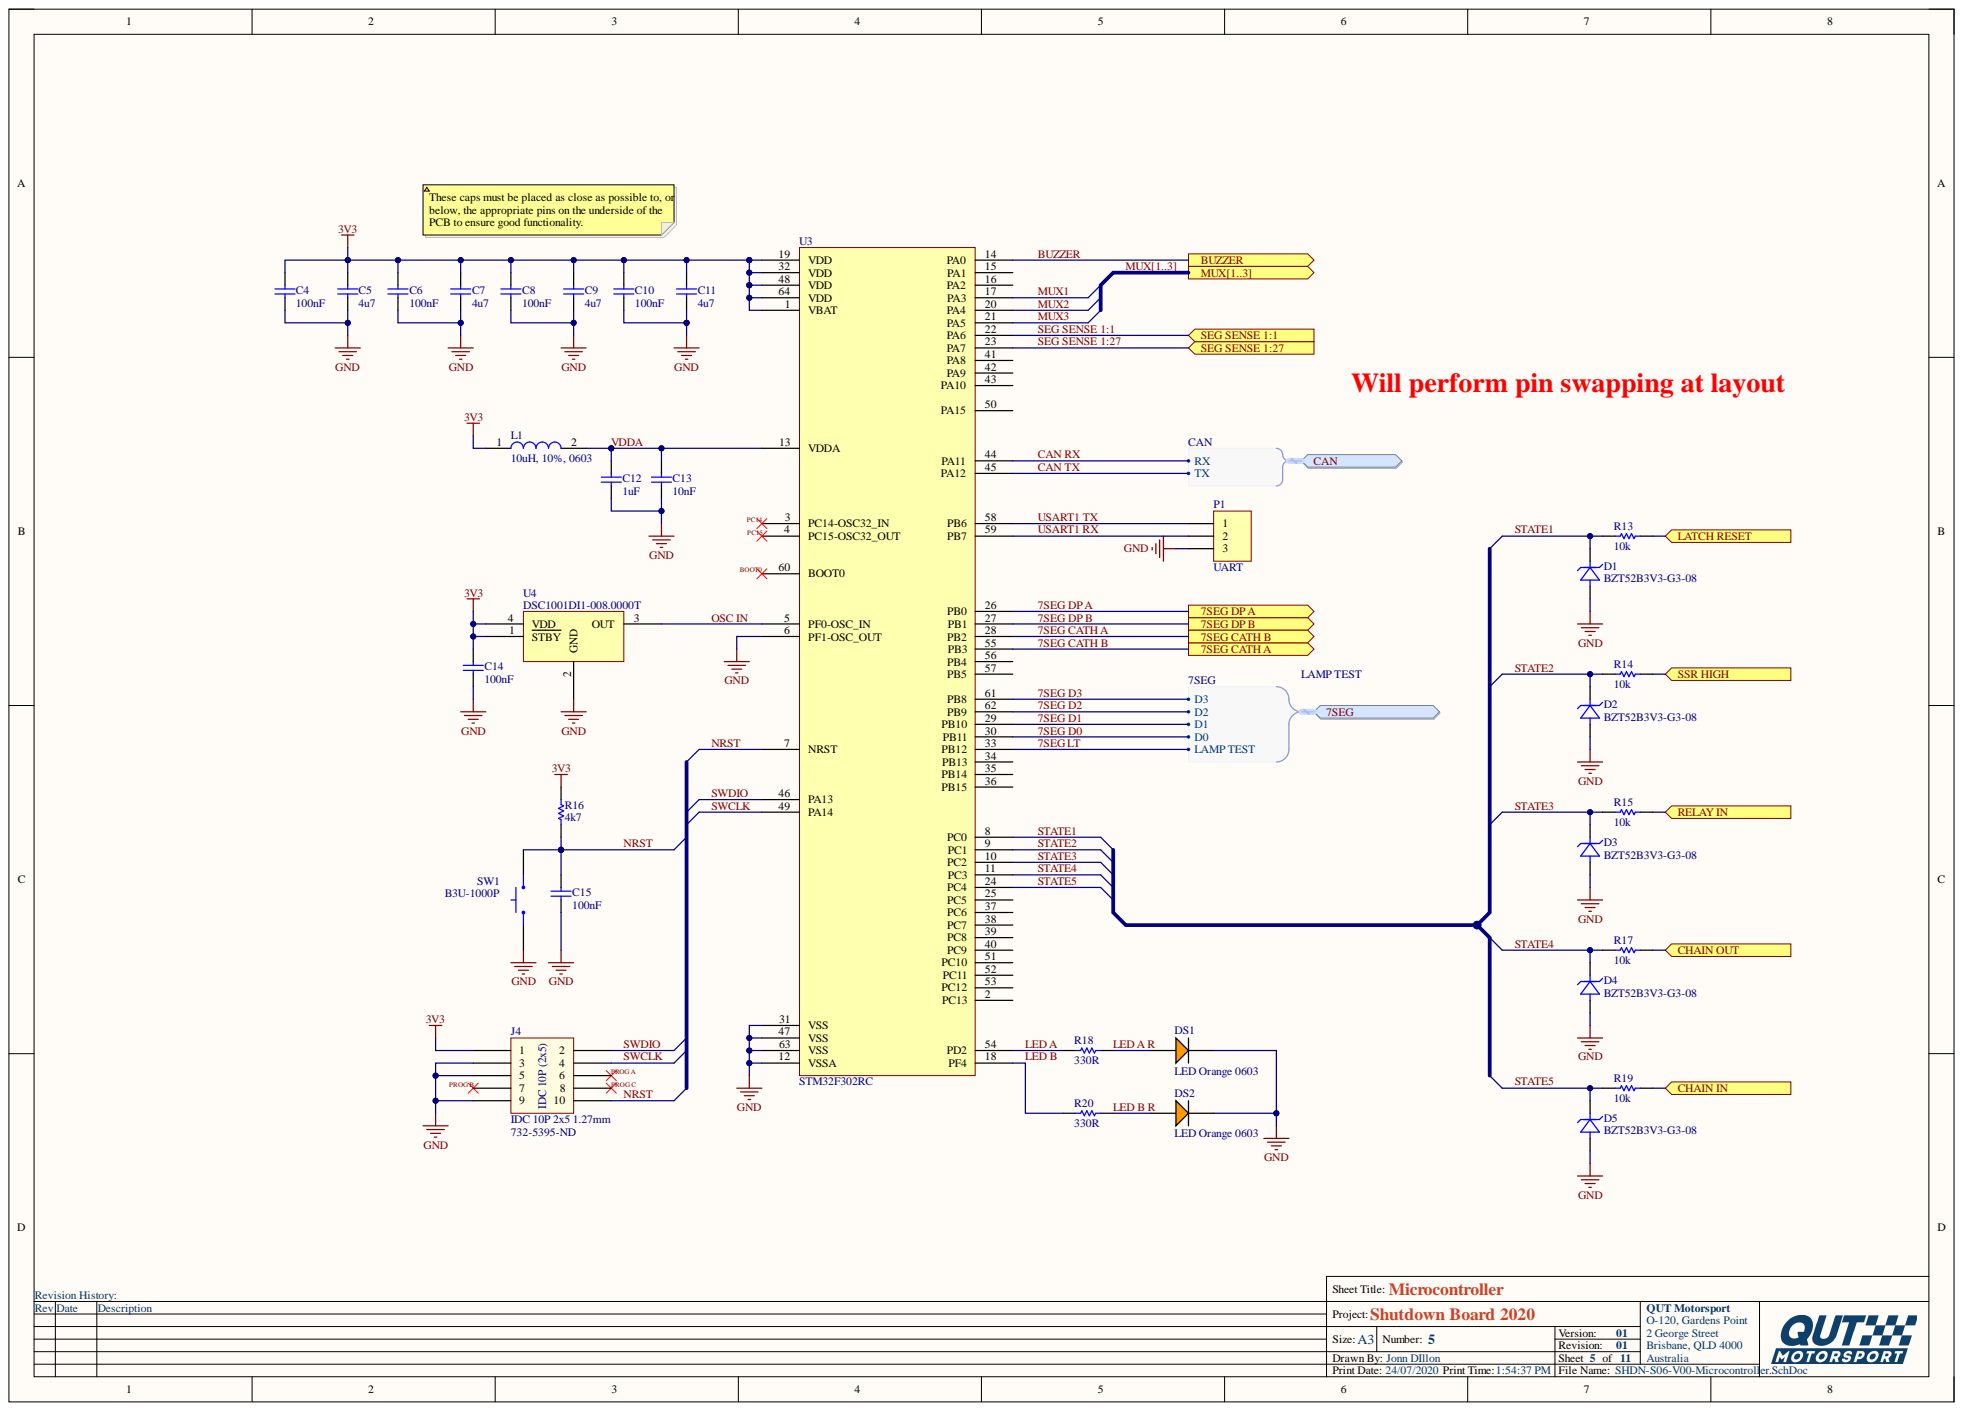
[picture p21: page 12]

t be placed as close as pos

Will perform pin swapping at layou

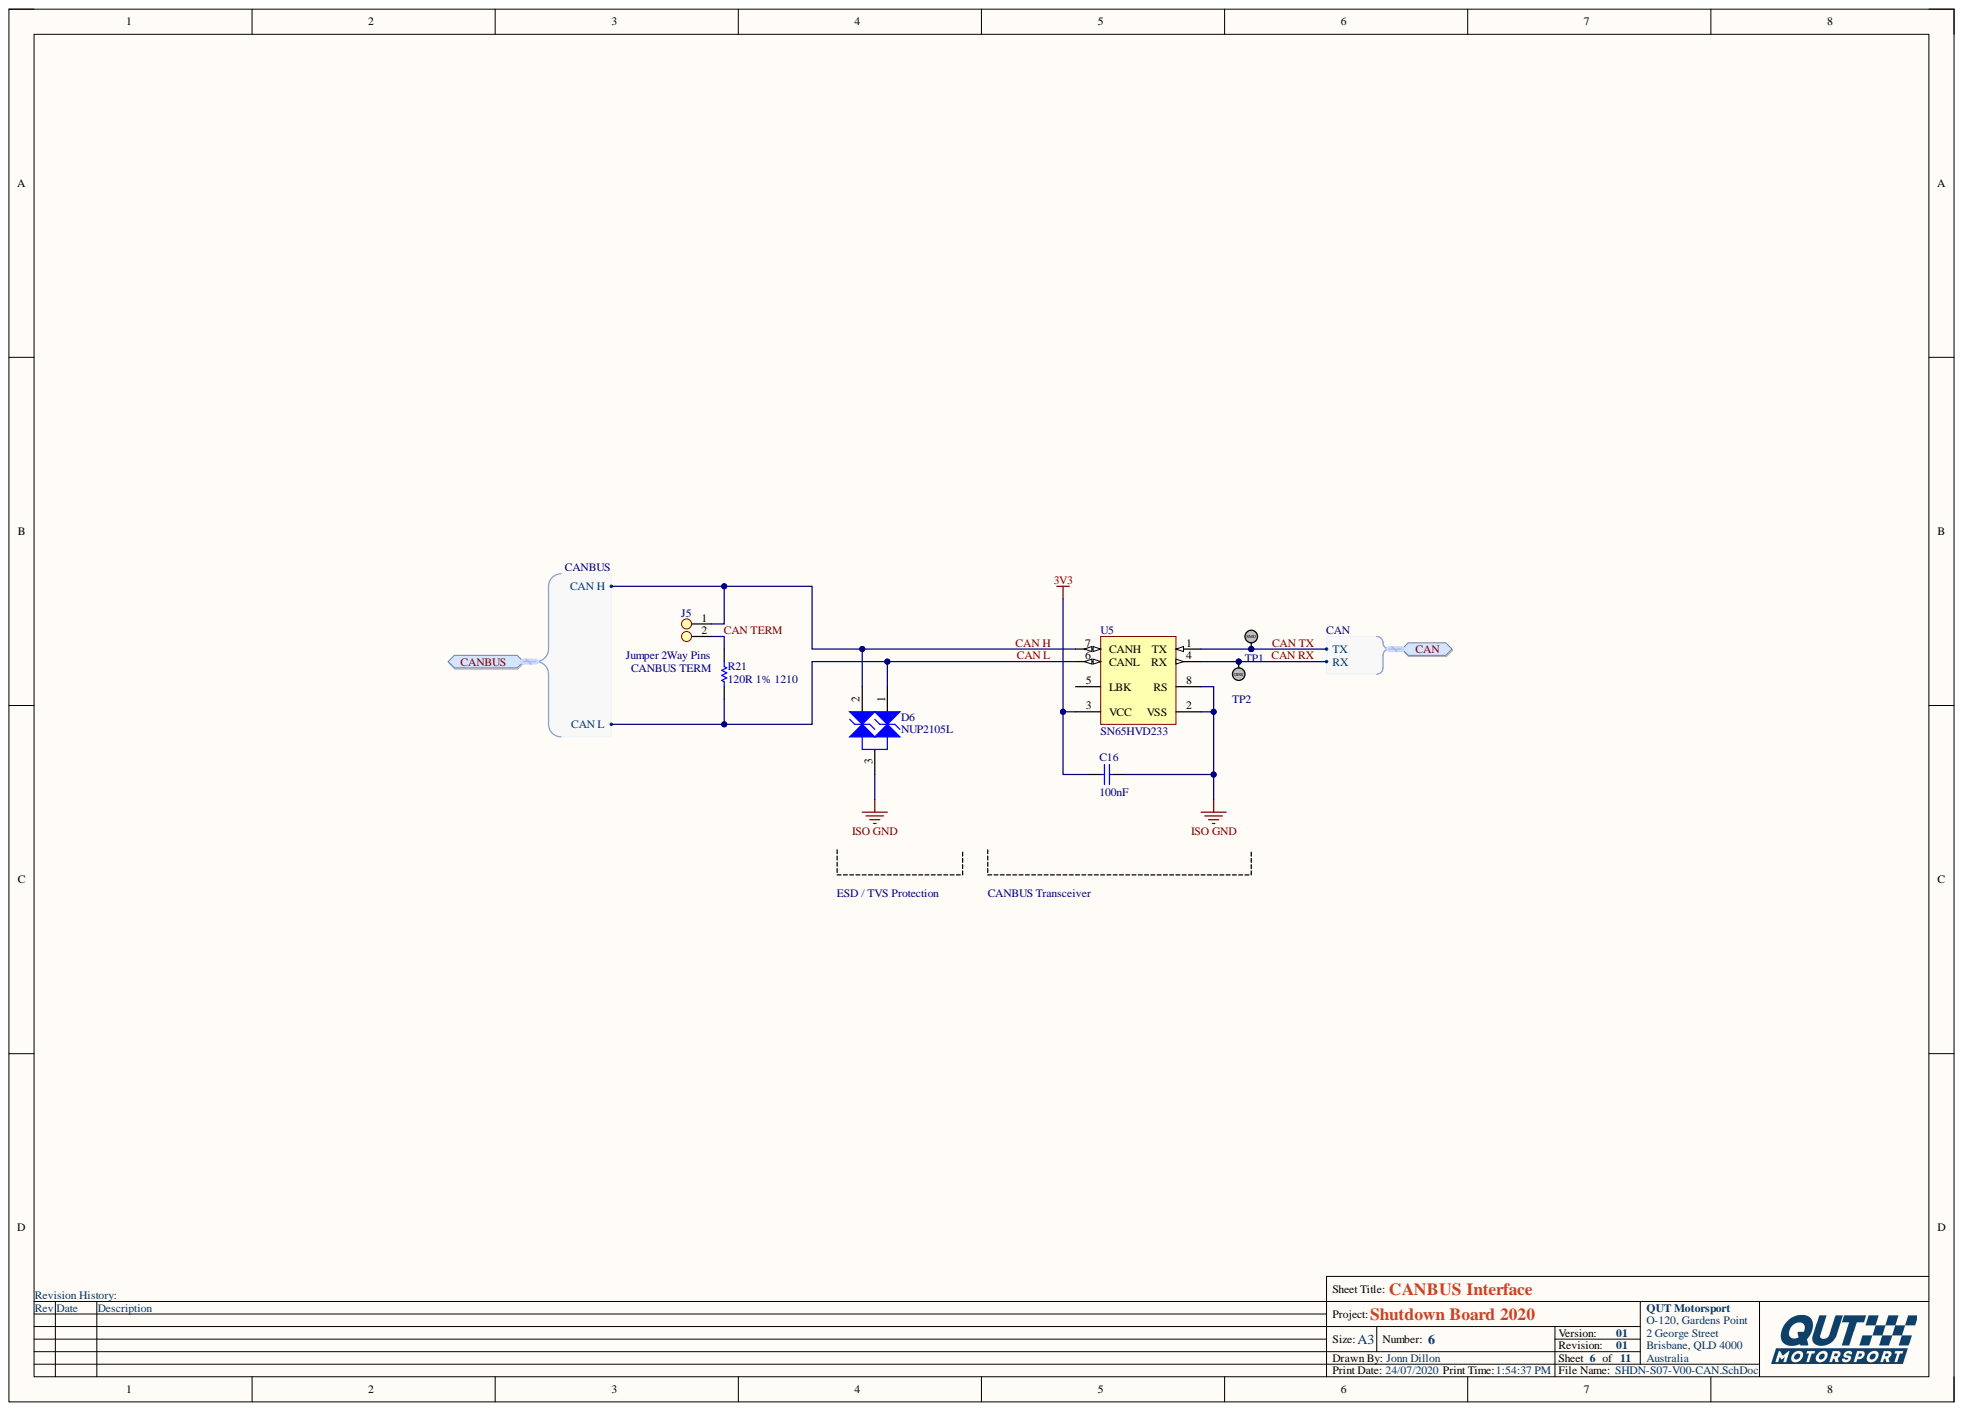
[picture p22: page 13]

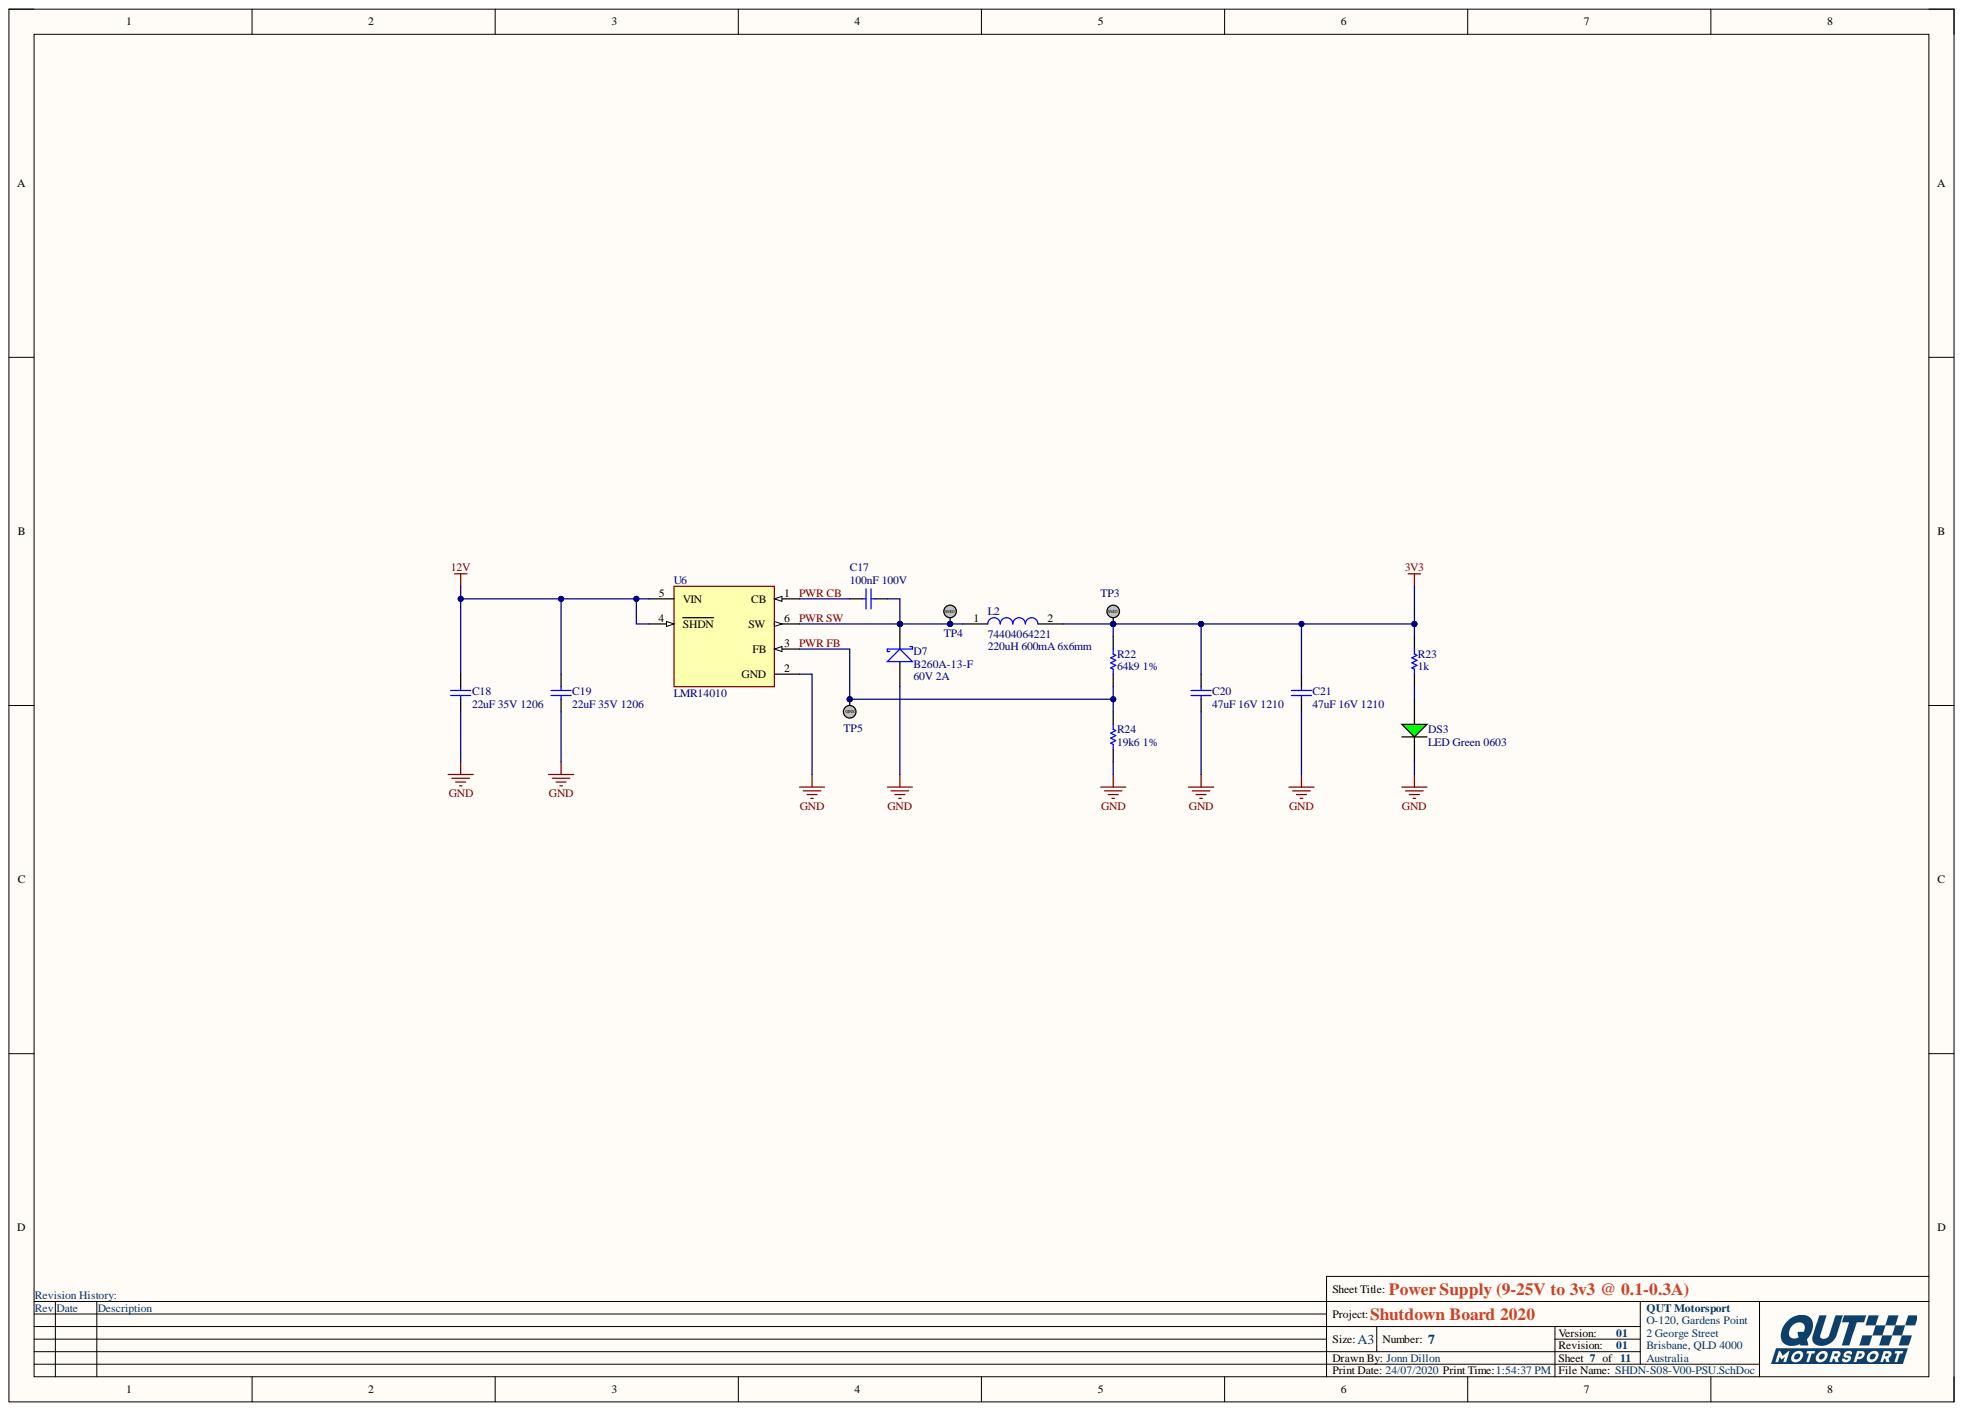
[picture p23: page 14]

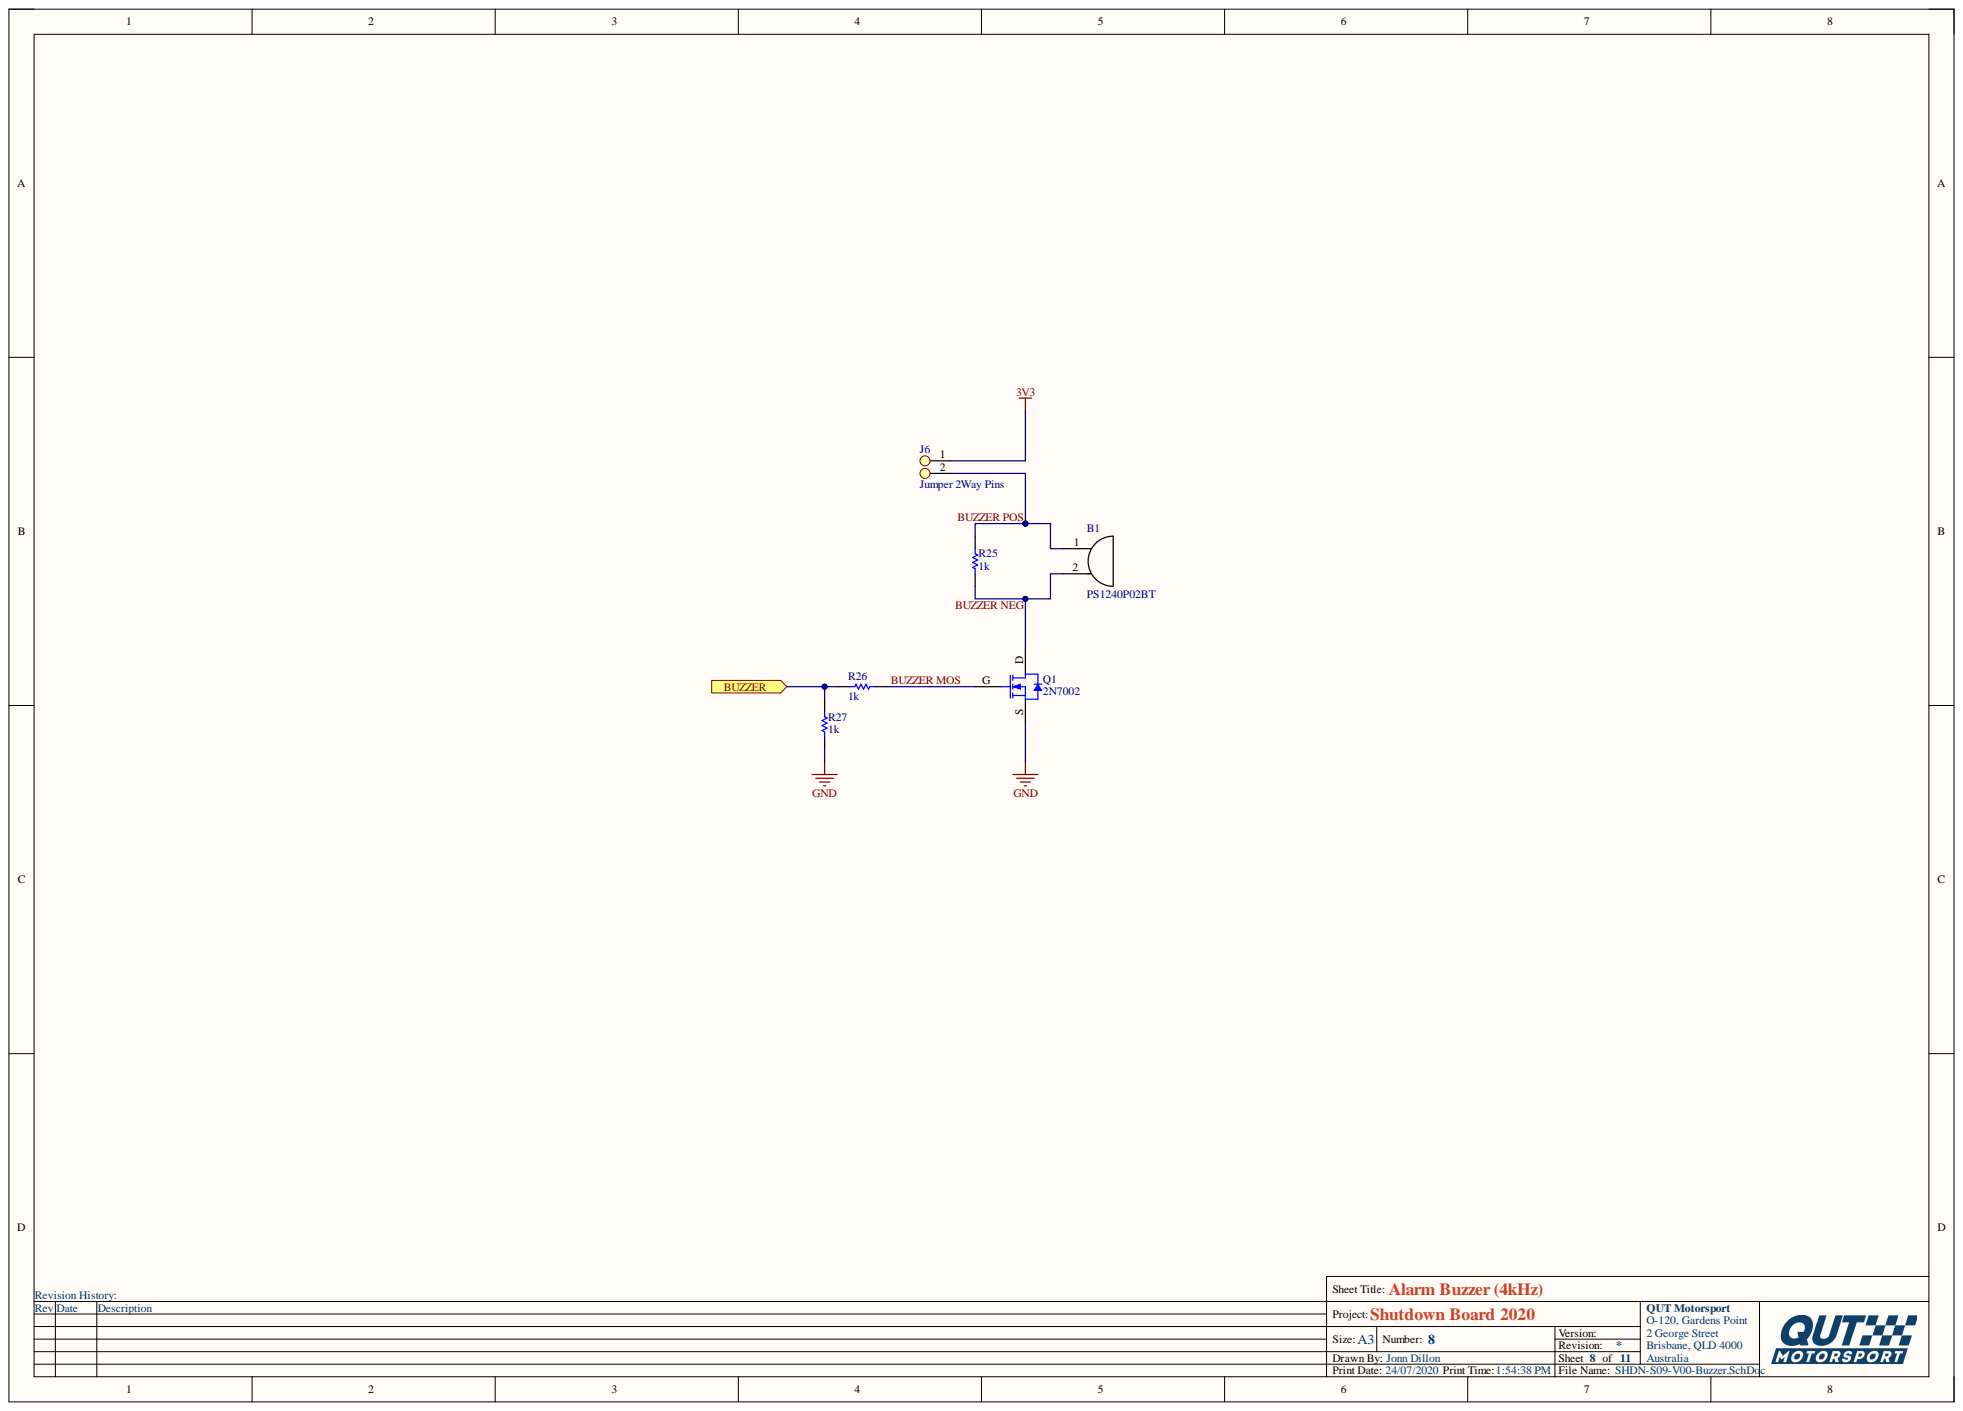
[picture p24: page 15]

Sheet Title: Alarm Buzzer (4kHz)
Shutdown Board 2020

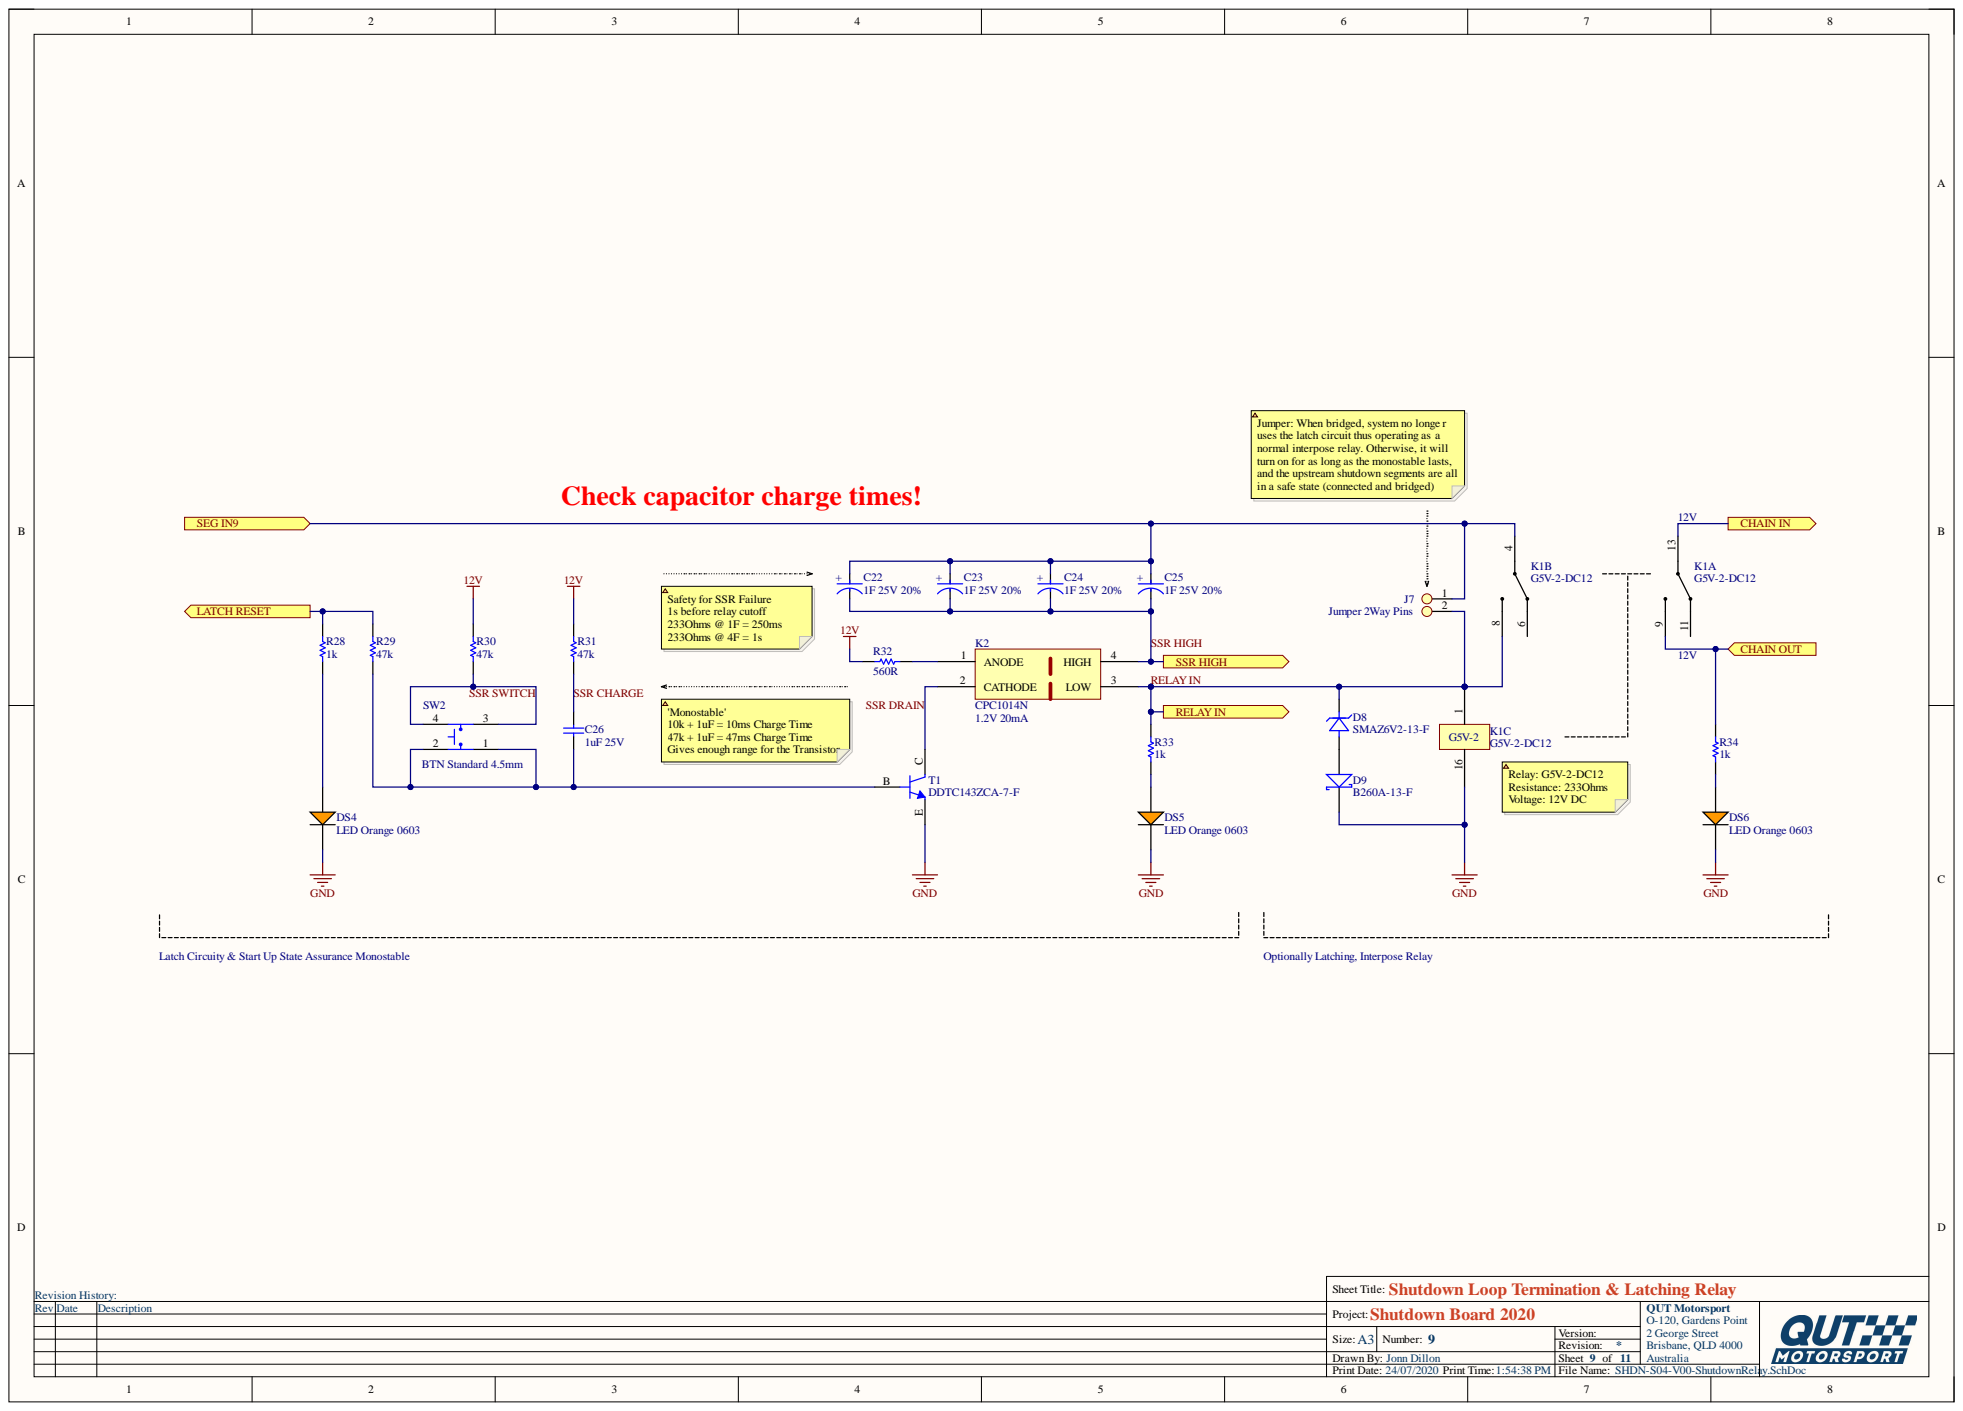
[picture p25: page 16]

umper
ses the latch ci
mal i
n on for as lon

Check capacitor charge times!

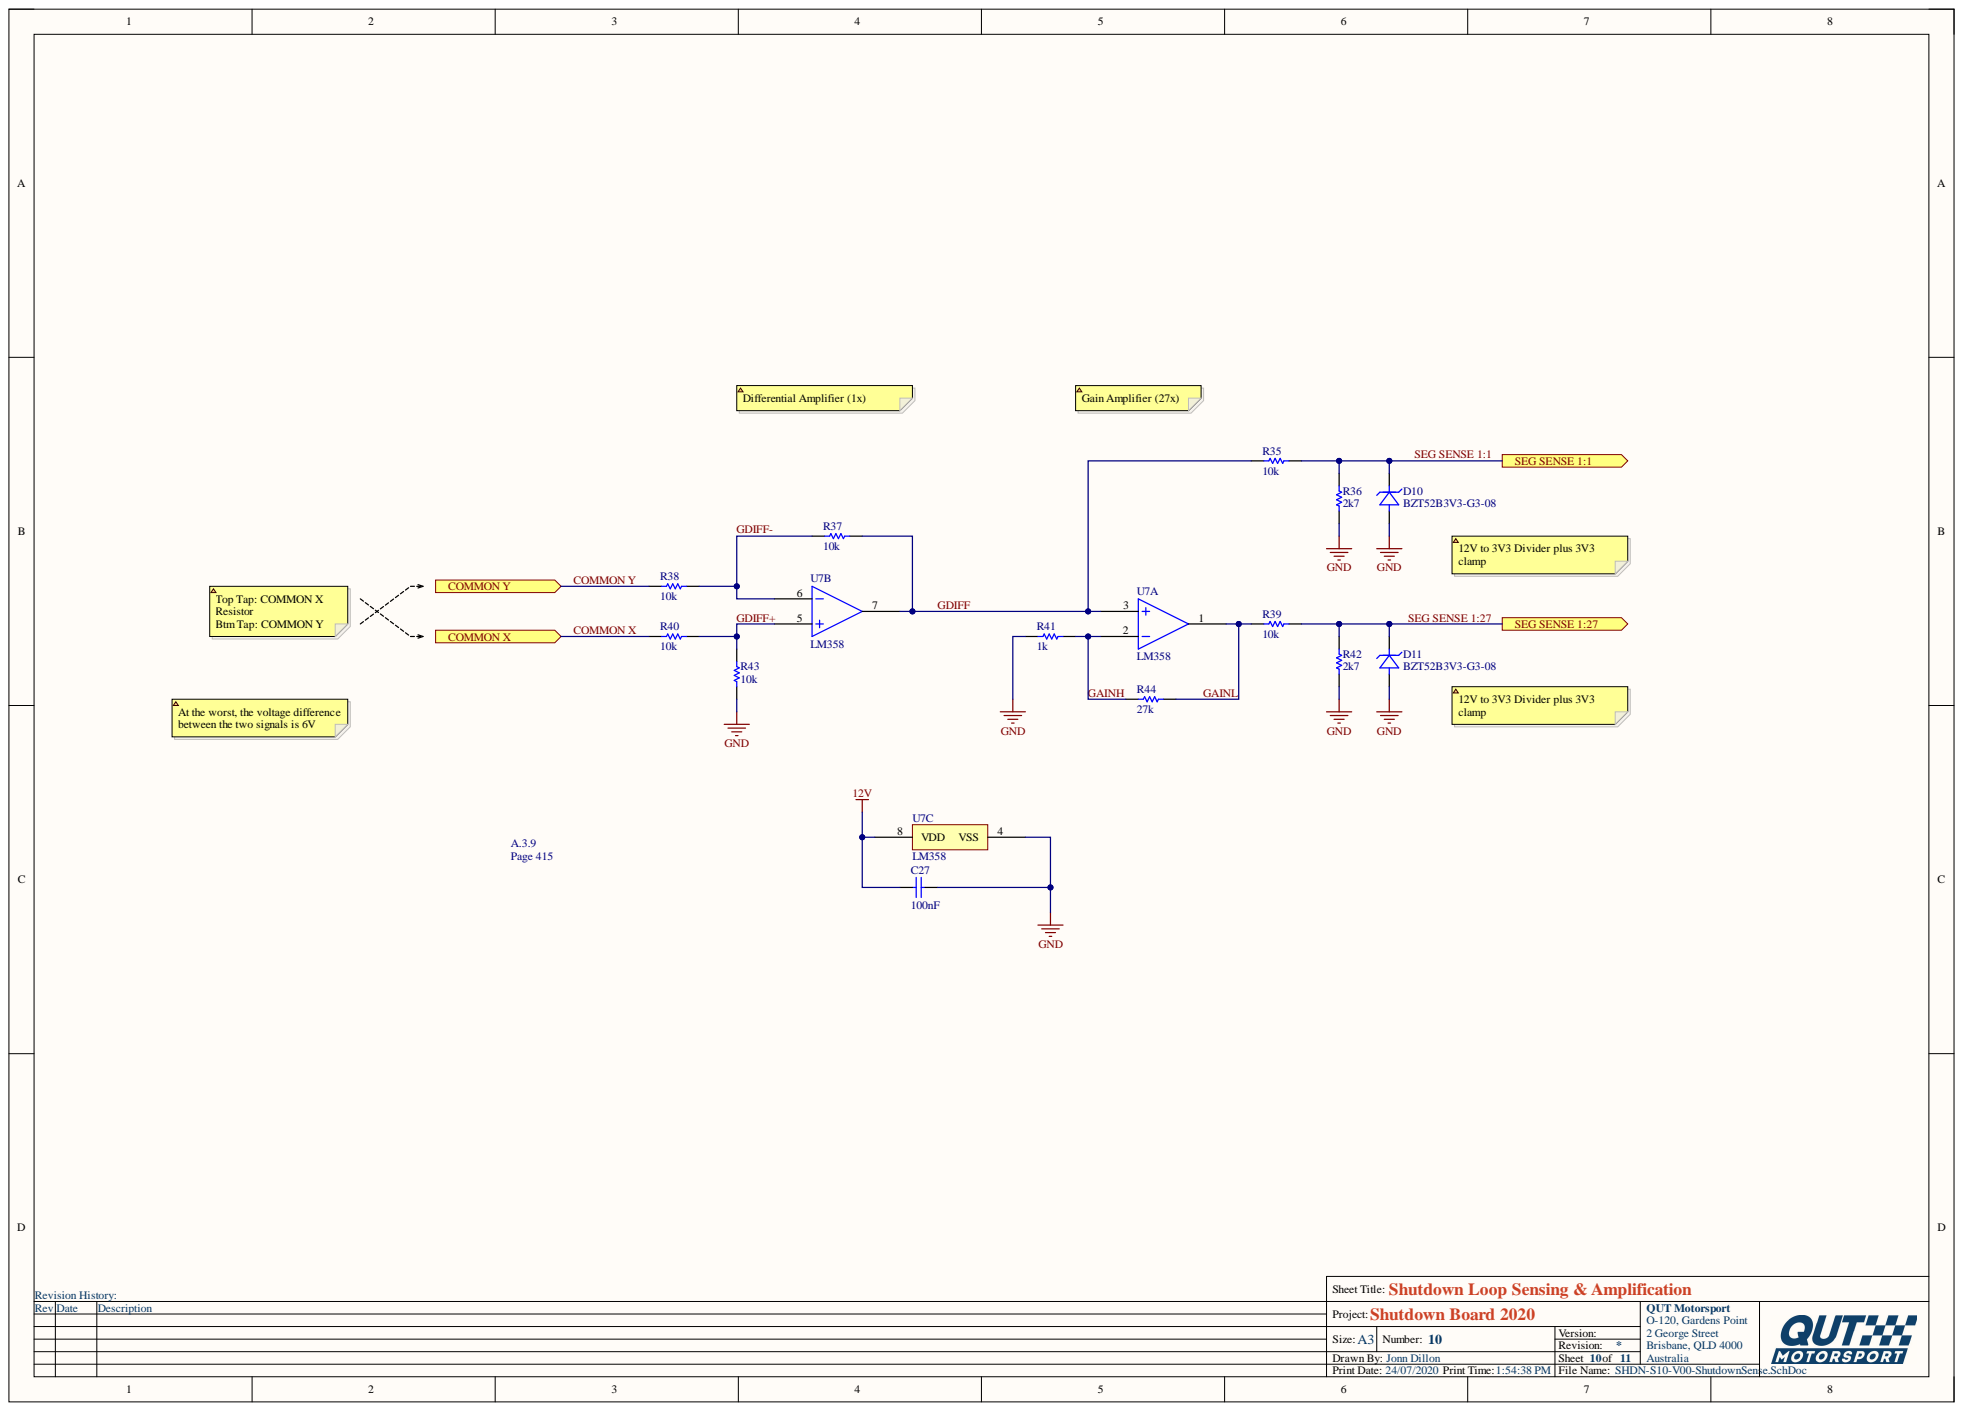
[picture p26: page 17]

SEG SENSE 1:1

SEG SENSE 1:27

At the worst, the voltage difference
between the two signals is 6V

Sheet Title: Shutdown Loop Sensing & Amplification
Shutdown Board 2020

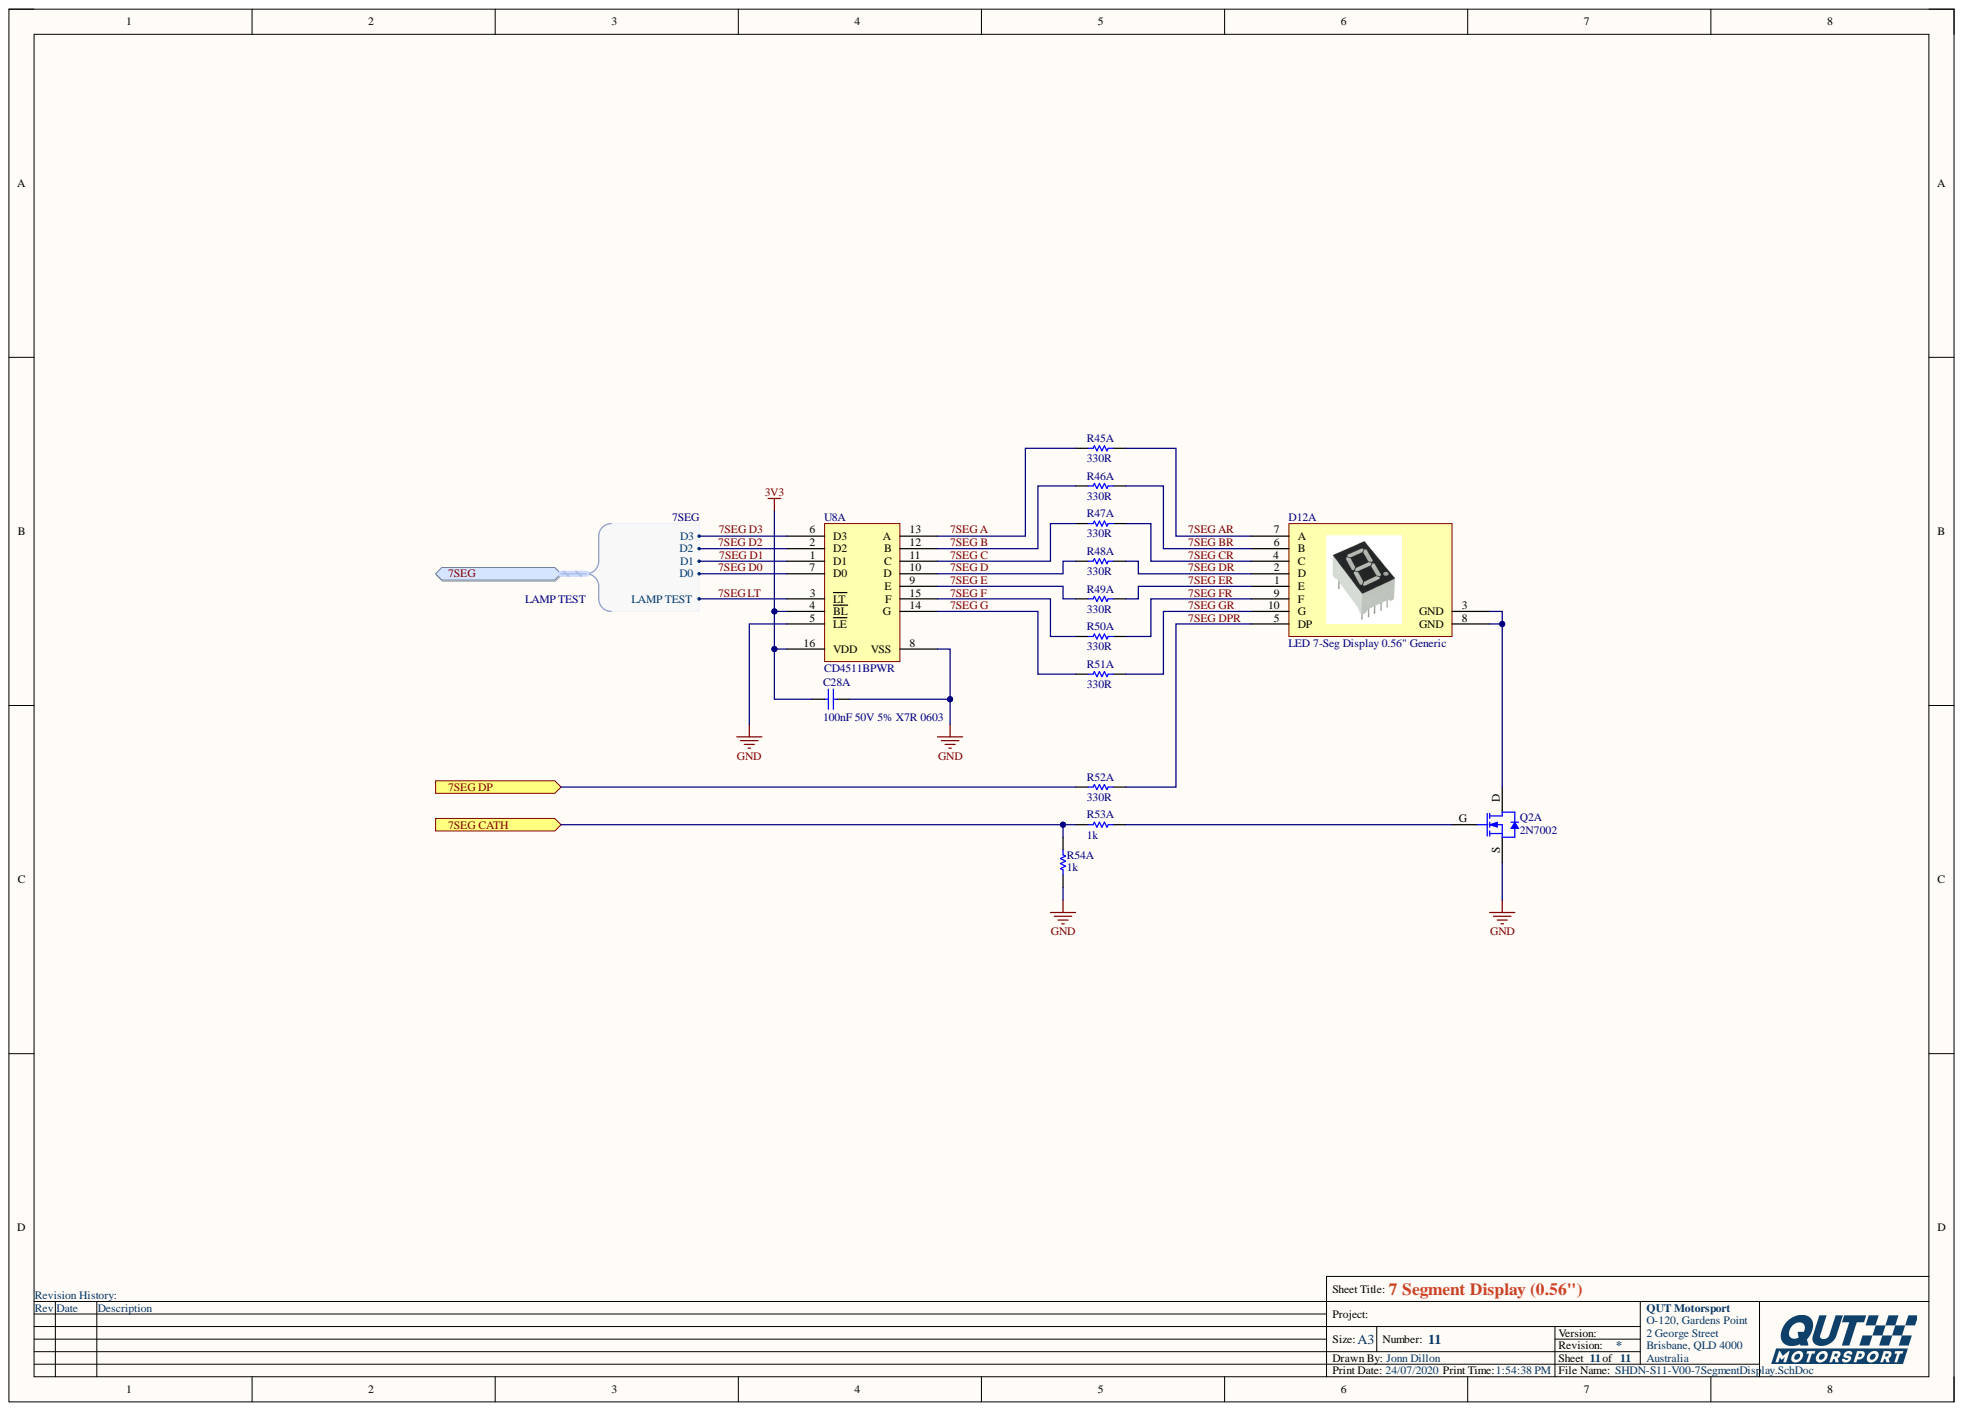
[picture p27: page 18]

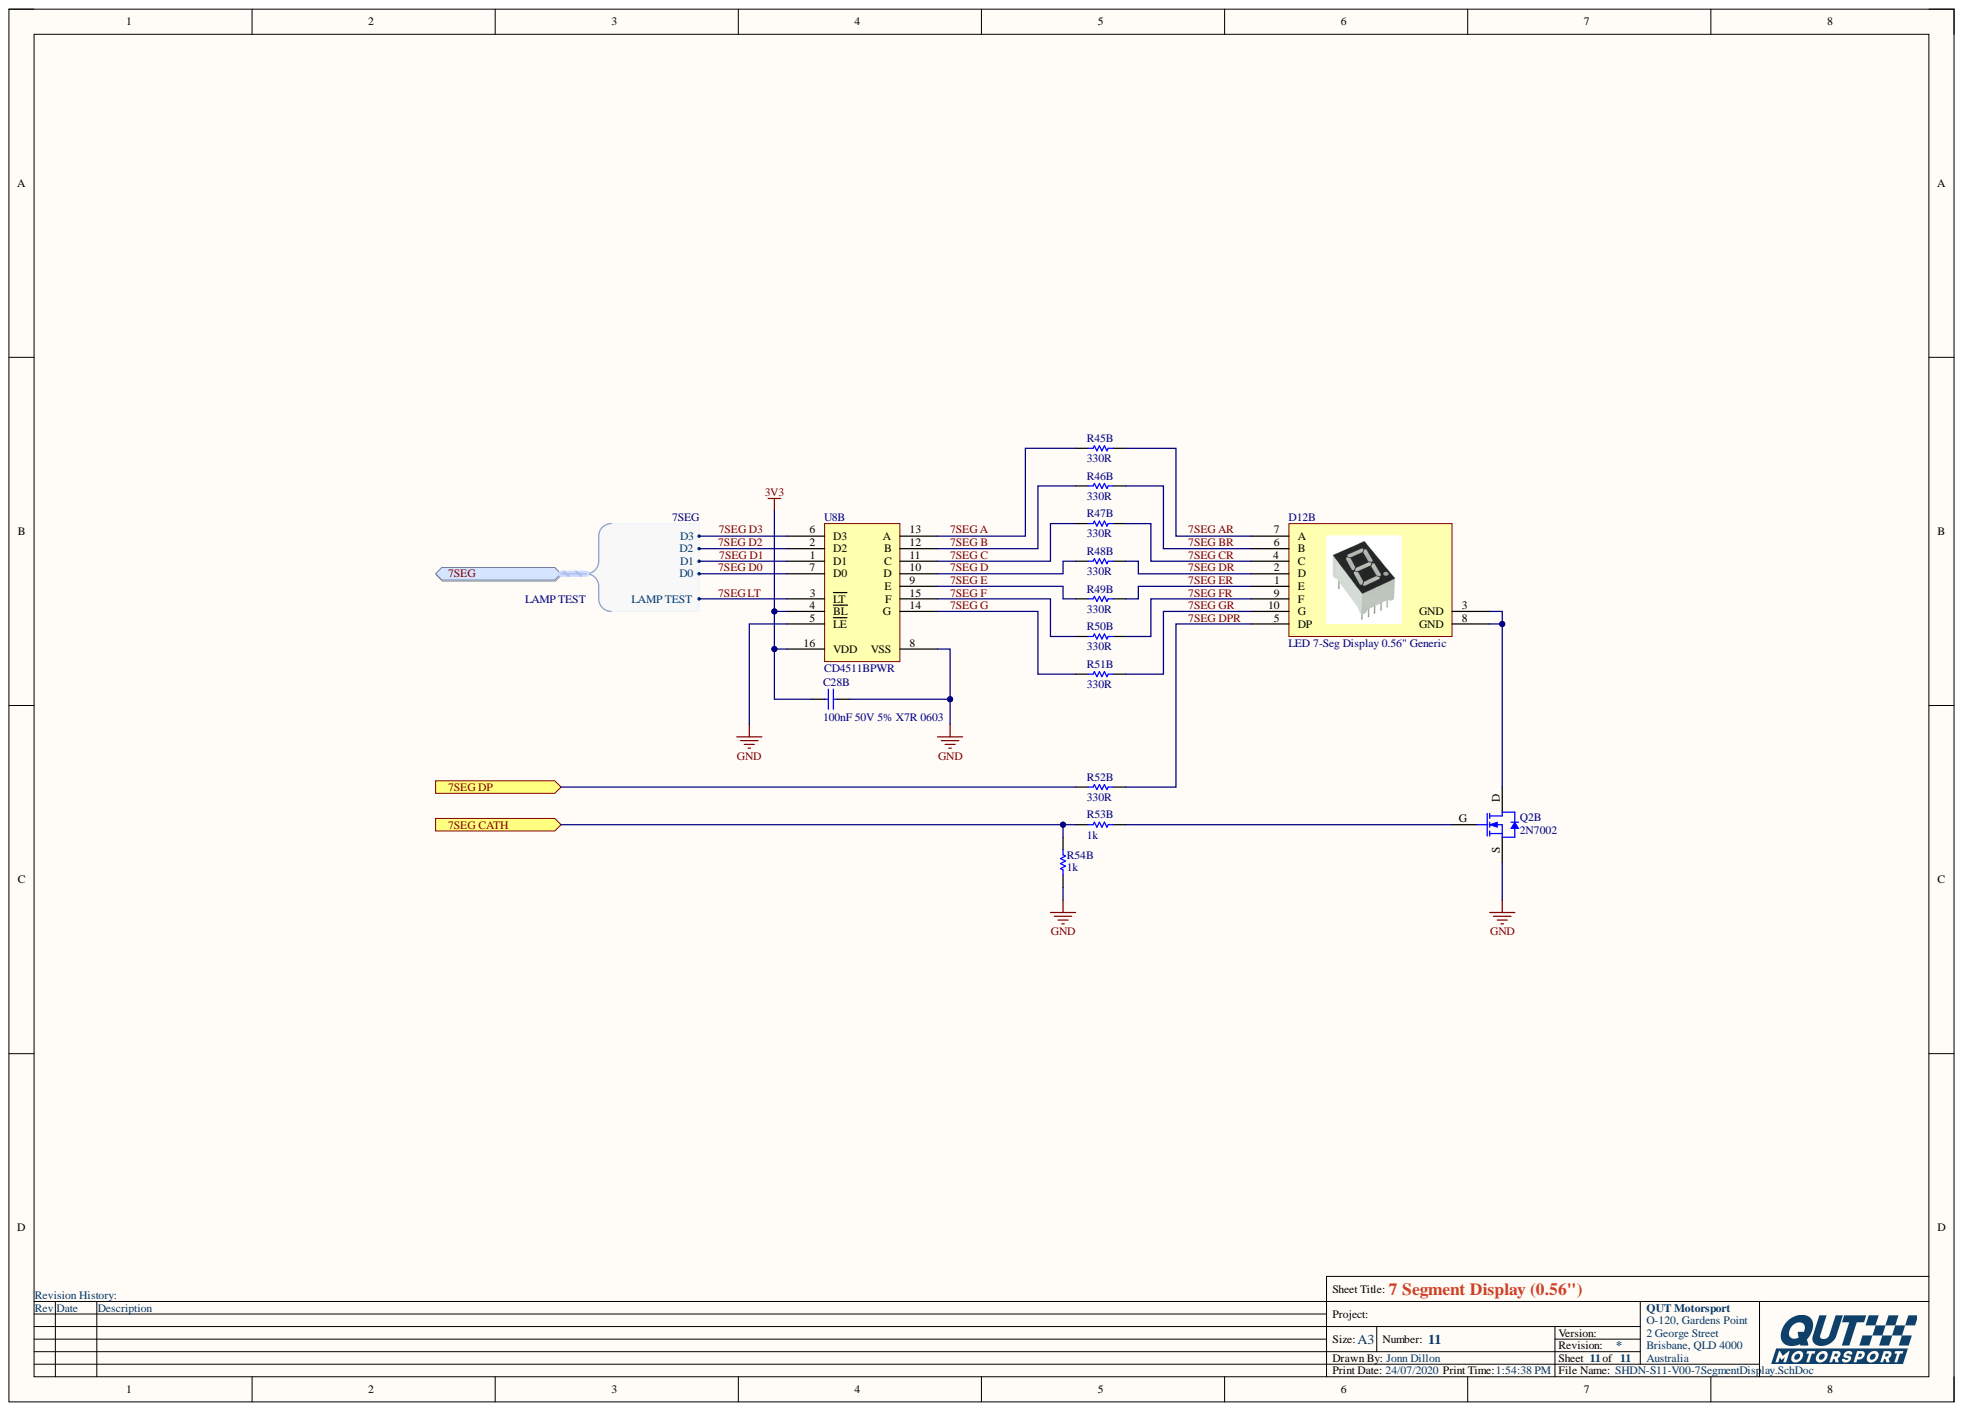
[picture p28: page 19]

LED 7-Seg Display 0.56" Generic

Sheet Title: 7 Segment Display (0.56")
