QUT-Motorsport/QUTMS_Shutdown/hardware/LTSpice/Draft1.asc

C1: cap; 1µ
R1: res; 2.2Meg; tol=5 pwr=0.25
V1: voltage; PULSE(0 12 5 10n 10n 5 10)
Named nets: 0
.tran 10
