QUT-Motorsport/QUTMS_Shutdown/hardware/LTSpice/SHDN21-DAC-LTSpiceSimulation.asc

D1: diode; 1N4148
D2: diode; 1N4148
D3: diode; 1N4148
D4: diode; 1N4148
R1: res; 4k7; tol=5 pwr=.1
R2: res; 10k; tol=5 pwr=.1
R3: res; 22k; tol=5 pwr=.1
R4: res; 47k; tol=5 pwr=.1
R5: res; 2k7; tol=5 pwr=.1
R6: res; 470; tol=5 pwr=0.25
R7: res; 470; tol=5 pwr=0.25
R8: res; 470; tol=5 pwr=0.25
R9: res; 470; tol=5 pwr=0.25
V1: voltage; PULSE(0 5 10m 1n 1n 10m 20m)
V2: voltage; PULSE(0 5 20m 1n 1n 20m 40m)
V3: voltage; PULSE(0 5 40m 1n 1n 40m 80m)
V4: voltage; PULSE(0 5 80m 1n 1n 80m 160m)
V5: voltage; 5
V6: voltage; PULSE(0 5 10m 1n 1n 10m 20m)
Named nets: 0, OUT, SHDN_DET_1, SHDN_DET_2, SHDN_DET_3, SHDN_DET_4
.tran 160ms
