QUT-Motorsport/QUTMS_Shutdown/(list of files, drawings)

Other design files:
hardware/Component Libraries/CellMonitor.PcbLib
hardware/Component Libraries/CellMonitor.SchLib
hardware/Component Libraries/FFCConnectors.PcbLib
hardware/Component Libraries/FFCConnectors.SchLib
hardware/Component Libraries/IDCConnectors.PcbLib
hardware/Component Libraries/IDCConnectors.SchLib
hardware/Component Libraries/OpAmpAttempt.SchLib
hardware/Component Libraries/QUTMS_BuzzerLibrary.PcbLib
hardware/Component Libraries/QUTMS_BuzzerLibrary.SchLib
hardware/Component Libraries/QUTMS_CANLibrary.PcbLib
hardware/Component Libraries/QUTMS_CANLibrary.SchLib
hardware/Component Libraries/QUTMS_CrystalLibrary.PcbLib
hardware/Component Libraries/QUTMS_CrystalLibrary.SchLib
hardware/Component Libraries/QUTMS_DiodeLibrary.PcbLib
hardware/Component Libraries/QUTMS_DiodeLibrary.SchLib
hardware/Component Libraries/QUTMS_InductorLibrary.PcbLib
hardware/Component Libraries/QUTMS_InductorLibrary.SchLib
hardware/Component Libraries/QUTMS_IntegratedCircuitLibrary.PcbLib
hardware/Component Libraries/QUTMS_IntegratedCircuitLibrary.SchLib
hardware/Component Libraries/QUTMS_IsolatorLibrary.PcbLib
hardware/Component Libraries/QUTMS_IsolatorLibrary.SchLib
hardware/Component Libraries/QUTMS_JumperLibrary.PcbLib
hardware/Component Libraries/QUTMS_JumperLibrary.SchLib
hardware/Component Libraries/QUTMS_JWPSConnector.SchLib
hardware/Component Libraries/QUTMS_LEDLibrary.PcbLib
hardware/Component Libraries/QUTMS_LEDLibrary.SchLib
hardware/Component Libraries/QUTMS_LogicLibrary.PcbLib
hardware/Component Libraries/QUTMS_LogicLibrary.SchLib
hardware/Component Libraries/QUTMS_MicrofitLibrary.PcbLib
hardware/Component Libraries/QUTMS_MicrofitLibrary.SchLib
hardware/Component Libraries/QUTMS_MolexLibrary.PcbLib
hardware/Component Libraries/QUTMS_MolexLibrary.SchLib
hardware/Component Libraries/QUTMS_OctocouplerLibrary.PcbLib
hardware/Component Libraries/QUTMS_OctocouplerLibrary.SchLib
hardware/Component Libraries/QUTMS_OpAmpLibrary.PcbLib
hardware/Component Libraries/QUTMS_OpAmpLibrary.SchLib
hardware/Component Libraries/QUTMS_OpAmps.PcbLib
hardware/Component Libraries/QUTMS_OpAmps.SchLib
hardware/Component Libraries/QUTMS_PCBLibrary.PcbLib
hardware/Component Libraries/QUTMS_PCBLibrary.SchLib
hardware/Component Libraries/QUTMS_RelayLibrary.PcbLib
hardware/Component Libraries/QUTMS_RelayLibrary.SchLib
hardware/Component Libraries/QUTMS_SDLibrary.PcbLib
hardware/Component Libraries/QUTMS_SDLibrary.SchLib
hardware/Component Libraries/QUTMS_STM32Library.PcbLib
hardware/Component Libraries/QUTMS_STM32Library.SchLib
hardware/Component Libraries/QUTMS_SwitchLibrary.PcbLib
hardware/Component Libraries/QUTMS_SwitchLibrary.SchLib
hardware/Component Libraries/QUTMS_Transistors.PcbLib
hardware/Component Libraries/QUTMS_Transistors.SchLib
hardware/Component Libraries/QUTMS_TrimmerLibrary.pcblib
hardware/Component Libraries/QUTMS_TrimmerLibrary.schlib
hardware/Component Libraries/StandardCapacitors.PcbLib
hardware/Component Libraries/StandardCapacitors.SchLib
hardware/Component Libraries/StandardResistors.PcbLib
hardware/Component Libraries/StandardResistors.SchLib
hardware/Component Libraries/StandardTest.PcbLib
hardware/Component Libraries/StandardTest.SchLib
hardware/QUTMS 2021 Shutdown Redesign.PrjPcb
hardware/QUTMS-SHDN-V00/SHDN-P01-V00.PcbDoc
hardware/SHDN21-S01-V00-Shutdown.SchDoc
hardware/SHDN21-S02-V00-SegInterface.SchDoc
hardware/SHDN21-S03-V00-DACResistors.SchDoc
