QUT-Motorsport/QUTMS_Shutdown/(commit log)

2020-06-29 Started work on main shutdown board. Added all previous libraries, set templates, made connector and requiste diagrams, started project structure
    [FFCConnectors.PcbLib, FFCConnectors.SchLib, IDCConnectors.PcbLib, IDCConnectors.SchLib, QUTMS-SHDN-V00.PrjPcb, QUTMS_CANLibrary.PcbLib, QUTMS_CANLibrary.SchLib, QUTMS_CrystalLibrary.PcbLib]
2020-06-29 Forgot to add project file
    [QUTMS-SHDN-V00.PrjPcb]
2020-06-30 Added more stuff
    [QUTMS_PowerSupplyLibrary.SchLib, SHDN-S01-V00-ShutdownBoard.SchDoc, SHDN-S02-V00-ShutdownSegments.SchDoc, SHDN-S04-V00-Connector.SchDoc, SHDN-S05-V00-Microcontroller.SchDoc, SHDN-S06-V00-IsolatedCAN.SchDoc, SHDN-S07-V00-PSU.SchDoc]
2020-07-01 Major work
    [G5V_1.SLDDRW, G5V_1.SLDPRT, G5V_1.igs, G5V_1.x_t, G5V_2.step, QUTMS_RelayLibrary.PcbLib, QUTMS_RelayLibrary.SchLib, SHDN-S02-V00-ShutdownSegments.SchDoc]
2020-07-01 Added project that was forgotten
    [QUTMS-SHDN-V00.PrjPcb]
2020-07-02 Changed sheets to be more divided and clear, added relays and cleaned sheets
    [G5Q_14.step, PS1240P02BT--3DModel-STEP-56544.STEP, QUTMS-SHDN-V00.PrjPcb, QUTMS_BuzzerLibrary.PcbLib, QUTMS_BuzzerLibrary.SchLib, QUTMS_MOSFETLibrary.PcbLib, QUTMS_MOSFETLibrary.SchLib, QUTMS_RelayLibrary.PcbLib]
2020-07-02 Added buzzer too
    [QUTMS-SHDN-V00.PrjPcb, SHDN-S01-V00-ShutdownBoard.SchDoc, SHDN-S03-V00-ShutdownSegment.SchDoc, SHDN-S04-V00-Connector.SchDoc, SHDN-S05-V00-Microcontroller.SchDoc, SHDN-S06-V00-IsolatedCAN.SchDoc, SHDN-S07-V00-PSU.SchDoc, SHDN-S08-V00-ShutdownSense.SchDoc]
2020-07-02 Added solid state relay to shutdownRelay sheet
    [CPC1014N--3DModel-STEP-56544.STEP, QUTMS_RelayLibrary.PcbLib, QUTMS_RelayLibrary.SchLib, SHDN-S01-V00-ShutdownBoard.SchDoc, SHDN-S10-ShutdownRelay.SchDoc]
2020-07-03 Finished shutdown structure
    [QUTMS_MuliplexerLibrary.PcbLib, QUTMS_MuliplexerLibrary.SchLib, SHDN-S01-V00-ShutdownBoard.SchDoc, SHDN-S02-V00-ShutdownSegments.SchDoc, SHDN-S02-V00-ShutdownSegmentsBackup.SchDoc, SHDN-S03-V00-ShutdownSegment.SchDoc, SHDN-S05-V00-Microcontroller.SchDoc, SHDN-S06-V00-IsolatedCAN.SchDoc]
2020-07-03 Added saved project
    [QUTMS-SHDN-V00.PrjPcb, SHDN-S02-V00-ShutdownSegments.SchDoc]
2020-07-07 Weekend work
    [DC-10.STEP, QUTMS-SHDN-V00.PrjPcb, QUTMS_CrystalLibrary.PcbLib, QUTMS_DiodeLibrary.PcbLib, QUTMS_DiodeLibrary.SchLib, QUTMS_LEDLibrary.PcbLib, QUTMS_LEDLibrary.SchLib, QUTMS_OpAmpLibrary.PcbLib]
2020-07-07 Started work on BSPD Board, added core files
    [FFCConnectors.PcbLib, FFCConnectors.SchLib, IDCConnectors.PcbLib, IDCConnectors.SchLib, QUTMS-SHDN-BSPD-V00.PrjPcb, QUTMS_BuzzerLibrary.PcbLib, QUTMS_BuzzerLibrary.SchLib, QUTMS_CANLibrary.PcbLib]
2020-07-07 Bulked out most of the structure for the BSPD board
    [QUTMS_CrystalLibrary.PcbLib, QUTMS_DiodeLibrary.PcbLib, QUTMS_DiodeLibrary.SchLib, QUTMS_LEDLibrary.PcbLib, QUTMS_LEDLibrary.SchLib, QUTMS_OpAmpLibrary.PcbLib, QUTMS_OpAmpLibrary.SchLib, QUTMS_PCBLibrary.PcbLib]
2020-07-07 Save of project
    [QUTMS-SHDN-CURRENT-V00.PrjPcb, SHDN-BSPD-S02-V00-BSPDSystem.SchDoc, SHDN-BSPD-S11-V00-Buzzer.SchDoc]
2020-07-08 mark Review
    [QUTMS-SHDN-BSPD-V00.PrjPcb, QUTMS_OpAmpLibrary.SchLib, SHDN-BSPD-S04-V00-BSPDWindowComparitor.SchDoc, SHDN-S02-V00-ShutdownSegments.SchDoc, SHDN-S04-V00-ShutdownRelay.SchDoc]
2020-07-09 More stuff
    [QUTMS-SHDN-BSPD-V00.PrjPcb, QUTMS_TrimmerLibrary.PcbLib, QUTMS_TrimmerLibrary.SchLib, SHDN-BSPD-S02-V00-BSPDSystem.SchDoc, SHDN-BSPD-S04-V00-BSPDWindowComparitor.SchDoc, SHDN-S02-V00-ShutdownSegments.SchDoc, SHDN-S05-V00-Connector.SchDoc, TC-33X-2.stp]
2020-07-09 made STM32F302 Part and changed connector for seg in and seg out operation
    [QUTMS-SHDN-V00.PrjPcb, QUTMS_InductorLibrary.PcbLib, QUTMS_InductorLibrary.SchLib, QUTMS_STM32Library.PcbLib, QUTMS_STM32Library.SchLib, SHDN-S05-V00-Connector.SchDoc, SHDN-S06-V00-Microcontroller.SchDoc, StandardCapacitors.SchLib]
2020-07-10 IMD Daughter board
    [CellMonitor.PcbLib, CellMonitor.SchLib, FFCConnectors.PcbLib, FFCConnectors.SchLib, HVBoard.PcbDoc, IDCConnectors.PcbLib, IDCConnectors.SchLib, QUTMS-BMS-V00.SCHLIB]
2020-07-10 more shutdown stuff
    [QUTMS-SHDN-V00.PrjPcb, QUTMS_RelayLibrary.SchLib, SHDN-P01-V00.PcbDoc, SHDN-S01-V00-ShutdownBoard.SchDoc, SHDN-S02-V00-ShutdownSegments.SchDoc, SHDN-S03-V00-ShutdownSegment.SchDoc, SHDN-S04-V00-ShutdownRelay.SchDoc, SHDN-S05-V00-Connector.SchDoc]
2020-07-11 Found issues in other projects, updated the IMD and relaid out the board accordingly
    [QUTMS-SHDN-IMD-V00.PrjPcb, SHDN-IMD-S00-V00-IMDDaughter.PcbDoc, SHDN-IMD-S04-V00-Microcontroller.SchDoc, SHDN-IMD-S05-V00-IsolatedCAN.SchDoc, SHDN-IMD-S06-V00-PSU.SchDoc, StandardCapacitors.SchLib]
2020-07-15 Finalised core BSPD functionality
    [QUTMS-SHDN-BSPD-V00.PrjPcb, QUTMS-SHDN-V00.PrjPcb, QUTMS_DiodeLibrary.SchLib, QUTMS_InductorLibrary.PcbLib, QUTMS_InductorLibrary.SchLib, QUTMS_LEDLibrary.PcbLib, QUTMS_LEDLibrary.SchLib, QUTMS_OpAmpLibrary.PcbLib]
2020-07-15 Forogt to add the project save
    [QUTMS-SHDN-BSPD-V00.PrjPcb]
2020-07-21 Added shutdown current board, due for review
    [DiffAmpCalculations.xlsx, FFCConnectors.PcbLib, FFCConnectors.SchLib, IDCConnectors.PcbLib, IDCConnectors.SchLib, JST_XH254.PcbLib, JST_XH254.SchLib, MOLEX_KK254.PcbLib]
2020-07-22 Added MUX to BSPD
    Implemented an 11:1 multiplexer IC for simplified BSPD microcontroller connections
    [D0008A.stp, QUTMS-SHDN-BSPD-V00.PrjPcb, QUTMS_MuliplexerLibrary.SchLib, QUTMS_PowerSupplyLibrary.PcbLib, QUTMS_PowerSupplyLibrary.SchLib, SHDN-BSPD-S01-V00-BSPDBoard.SchDoc, SHDN-BSPD-S02-V00-BSPDSystem.SchDoc, SHDN-BSPD-S03-V00-Connectivity.SchDoc]
2020-07-23 Almost done
    Schematics are basically complete, just need to sourt out error messages
    [QUTMS-SHDN-BSPD-V00.PrjPcb, SHDN-BSPD-S01-V00-BSPDBoard.SchDoc, SHDN-BSPD-S02-V00-BSPDSystem.SchDoc, SHDN-BSPD-S03-V00-VoltageDivider.SchDoc, SHDN-BSPD-S04-V00-BSPDWindowComparitor.SchDoc, SHDN-BSPD-S05-V00-BSPDDelay.SchDoc, SHDN-BSPD-S06-V00-BSPDSense.SchDoc, SHDN-BSPD-S07-V00-Microcontroller.SchDoc]
2020-07-23 Buttoned up all shutdown board sheets, ready for reviwal and final pursal
    [QUTMS-SHDN-V00.PrjPcb, QUTMS_DiodeLibrary.PcbLib, QUTMS_DiodeLibrary.SchLib, QUTMS_LEDLibrary.SchLib, QUTMS_MOSFETLibrary.PcbLib, QUTMS_MOSFETLibrary.SchLib, QUTMS_OpAmpLibrary.PcbLib, QUTMS_OpAmpLibrary.SchLib]
2020-07-24 Review Push
    [QUTMS-SHDN-BSPD-V00.PrjPcb, QUTMS-SHDN-CURRENT-V00.PrjPcb, QUTMS_LEDLibrary.SchLib, SHDN-BSPD-S01-V00-BSPDBoard.SchDoc, SHDN-BSPD-S02-V00-BSPDSystem.SchDoc, SHDN-BSPD-S03-V00-VoltageDivider.SchDoc, SHDN-BSPD-S04-V00-BSPDWindowComparitor.SchDoc, SHDN-BSPD-S05-V00-BSPDDelay.SchDoc]
2020-07-24 Post review changes implimented for BSPD
    [QUTMS-SHDN-BSPD-V00.PrjPcb, QUTMS-SHDN-CURRENT-V00.PrjPcb, QUTMS-SHDN-V00.PrjPcb, SHDN-BSPD-S01-V00-BSPDBoard.SchDoc, SHDN-BSPD-S02-V00-BSPDSystem.SchDoc, SHDN-BSPD-S04-V00-BSPDWindowComparitor.SchDoc, SHDN-BSPD-S05-V00-BSPDDelay.SchDoc, SHDN-BSPD-S07-V00-Microcontroller.SchDoc]
2020-07-24 Fixed Schematic Numbering
    After removing two schematic files, the rest had to be renumbered and parts annotated
    [D0008A.stp, QUTMS-SHDN-BSPD-V00.PrjPcb, SHDN-BSPD-S01-V00-BSPDBoard.SchDoc, SHDN-BSPD-S02-V00-BSPDSystem.SchDoc, SHDN-BSPD-S03-V00-BSPDWindowComparitor.SchDoc, SHDN-BSPD-S03-V00-VoltageDivider.SchDoc, SHDN-BSPD-S04-V00-BSPDDelay.SchDoc, SHDN-BSPD-S04-V00-BSPDWindowComparitor.SchDoc]
2020-07-24 Schematic fix and restructure
2020-07-25 Semi-Complete Board layout
    All components have been placed on the board. needs to be routed and designators positioned
    [QUTMS-SHDN-BSPD-V00.PrjPcb, QUTMS_OpAmpLibrary.PcbLib, QUTMS_RelayLibrary.SchLib, QUTMS_STM32Library.PcbLib, QUTMS_STM32Library.SchLib, SHDN-BSPD-S01-V00-BSPDBoard.SchDoc, SHDN-BSPD-S02-V00-BSPDSystem.SchDoc, SHDN-BSPD-S03-V00-BSPDWindowComparitor.SchDoc]
2020-07-25 Board Layout Complete
    PCB has been fully routed and components labelled. Routing was rushed with many vias and a ground plane segment is almost electrically cutoff. Circuitry should be improved before production. 3D CAD file also added.
    [SHDN-BSPD-S01-V00-BSPDBoard.SchDoc, SHDN-BSPD-S05-V00-Microcontroller.SchDoc, SHDN-BSPD-S10-V00-Connectivity.SchDoc]
2020-07-26 Finished layout of Shutdown Board
    [QUTMS-SHDN-CURRENT-V00.PrjPcb, QUTMS-SHDN-V00.PrjPcb, QUTMS_DiodeLibrary.PcbLib, QUTMS_DiodeLibrary.SchLib, QUTMS_MOSFETLibrary.PcbLib, QUTMS_MOSFETLibrary.SchLib, QUTMS_Transistors.schlib, SHDN-CURRENT-S06-V00-5kWSimulation.SchDoc]
2020-07-26 Finished SHDN-Current board layout, and made output job files for that and SHDN board too
    [QUTMS-SHDN-CURRENT-V00.PrjPcb, QUTMS-SHDN-V00.PrjPcb, QUTMS_RelayLibrary.SchLib, QUTMS_SpecialResistors.PcbLib, SHDN-CURRENT-S01-V00-CurrentBoard.SchDoc, SHDN-CURRENT-S02-V00-Microcontroller.SchDoc, SHDN-CURRENT-S03-V00-IsolatedCAN.SchDoc, SHDN-CURRENT-S04-V00-PSU-3V3.SchDoc]
2020-07-26 Fixed the few ground plane issues
2020-07-28 Minor DRC Edits
    [QUTMS-SHDN-BSPD-V00.PrjPcb, SHDN-BSPD-S01-V00-BSPDBoard.SchDoc, SHDN-BSPD-S03-V00-BSPDWindowComparitor.SchDoc, SHDN-BSPD-S10-V00-Connectivity.SchDoc]
2020-07-28 BSPD Ready for Manufacture
    [QUTMS-SHDN-BSPD-V00.PrjPcb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]
2020-11-09 intial shutdown board software setup
2020-11-09 LED's flashing
2020-11-10 interrupt on chain out
2020-11-10 send can message on shutdown interrupt
2020-11-10 change shutdown triggered to be on the relay input
2021-01-01 2021 Shutdown Redesign
    2021 Shutdown Redesign, including exported PDF of schematics. Component footprint additions and PCB design not commenced yet, latest schematic draft under revision
    [QUTMS 2021 Shutdown Redesign.PrjPcb, QUTMS-SHDN-CURRENT-V00.PrjPcb, QUTMS_MolexLibrary.SchLib, SHDN-CURRENT-S08-V00-5kWDetection.SchDoc, SHDN-IMD-S00-V00-IMDDaughter.PcbDoc, SHDN21-S01-V00-Shutdown.SchDoc, SHDN21-S02-V00-SegInterface.SchDoc, SHDN21-S03-V00-DACResistors.SchDoc]
2021-01-01 Cleaning up. removing old versions
    [CPC1014N--3DModel-STEP-56544.STEP, CellMonitor.PcbLib, CellMonitor.SchLib, DC-10.STEP, DiffAmpCalculations.xlsx, FFCConnectors.PcbLib, FFCConnectors.SchLib, G5Q_14.step]
2021-01-03 Work on missing component footprints
    Created some footprints for new components. Some footprints still missing, WIP
    [PCB1.PcbDoc, QUTMS 2021 Shutdown Redesign.PrjPcb, QUTMS_DiodeLibrary.SchLib, QUTMS_IntegratedCircuitLibrary.PcbLib, QUTMS_IntegratedCircuitLibrary.SchLib, QUTMS_LogicLibrary.PcbLib, QUTMS_LogicLibrary.SchLib, QUTMS_MolexLibrary.PcbLib]
2021-01-03 Footprint issues fixed, PCB design ready to commence
    Footprint issues apparently fixed, now ready for PCB design to go ahead. Added DZ Snubber in parrallel with relay coil for protection and 2-pin headers to bypass shutdown segments.
    [QUTMS 2021 Shutdown Redesign.PrjPcb, QUTMS_DiodeLibrary.SchLib, SHDN21-P01-V00.PcbDoc, SHDN21-S01-V00-Shutdown.SchDoc, SHDN21-S02-V00-SegInterface.SchDoc]
2021-01-03 initial pcb draft
    [QUTMS 2021 Shutdown Redesign.PrjPcb, SHDN21-P01-V00.PcbDoc, SHDN21-S01-V00-Shutdown.SchDoc]
2021-01-05 PCB Layout draft Ver2
    Component layout draft completed for second round of revision. Routing has not yet commenced in case significant rearrangements of components need to be made
    [143626.stp, LY4.SLDPRT, QUTMS 2021 Shutdown Redesign.PrjPcb, QUTMS_JumperLibrary.PcbLib, QUTMS_JumperLibrary.SchLib, QUTMS_MolexLibrary.PcbLib, QUTMS_RelayLibrary.PcbLib, SHDN21-S01-V00-Shutdown.SchDoc]
2021-01-07 3rd rev component placement complete
    3rd revision of component placement of complete. Routing ready to commence.
    Several key changes/additions:
    - Readjustment of relay connections to make AIR current-carrying routing more convenient
    - Addition of DIP switches on underside of board to bypass shutdown segments (WARNING: These switches CANNOT be flicked when the shutdown loop is high. They must remain in the start they were in when the shutdown loop went high until the shutdown loop goes low again, to prevent damage.)
    - Silkscreen board title and QUTMS logo on underside of board
    - 4x3.2mm mounting holes and 3x fiducials added
    - Testing points added for multiple PSUs
    - Chain header configuration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
    [219-3poles.stp, CVS-03TB.stp, QUTMS 2021 Shutdown Redesign.PrjPcb, QUTMS_MolexLibrary.PcbLib, QUTMS_RelayLibrary.PcbLib, QUTMS_RelayLibrary.SchLib, QUTMS_SwitchLibrary.PcbLib, QUTMS_SwitchLibrary.SchLib]
2021-01-08 initial routing complete except for ground layer and 12vp
    [SHDN21-S01-V00-Shutdown.SchDoc]
2021-01-08 finished pcb routing
2021-01-11 incorporating feedback from mark
    [QUTMS 2021 Shutdown Redesign.PrjPcb, SHDN21-S01-V00-Shutdown.SchDoc, SHDN21-S02-V00-SegInterface.SchDoc]
2021-01-12 Mark's review 12th Jan 2021
    [QUTMS 2021 Shutdown Redesign.PrjPcb, SHDN21-S01-V00-Shutdown.SchDoc]
2021-01-12 fix from mark's feedback 12jan
    [SHDN21-S01-V00-Shutdown.SchDoc]
2021-01-12 board outline clearance constraint persisting
2021-01-12 Fixed polygon overhanging board edge
    Reduced polygon clearance back to 0.5mm
    Minor routing changes
    Increased thermal relief thickness for GND pads on chain in/out connectors
2021-01-12 renamed DAC + added labeling
    [SHDN21-S01-V00-Shutdown.SchDoc]
2021-01-12 round pcb corners
2021-01-12 Review and minor edits
    Re-positioned and added mounting holes
    Resizes silk circle around mounting holes to better indicate limit safe area (copper-free)
    Re-positioned fiducials
    Minor routing and silk placement edits
    Added testpoints for DAC channels
    Tented top layer vias on SMD pads to mitigate solder migration
    Pulled back GND plane pour from shutdown loop connections and bypass switches
    Moved origin to corner of board
    [QUTMS 2021 Shutdown Redesign.PrjPcb, SHDN21-S01-V00-Shutdown.SchDoc]
2021-01-13 clean up hardware folder
    [PCB1.PcbDoc]
2021-10-12 make this 12v 5v next ttime
    [SHDN21-S01-V00-Shutdown.SchDoc]
