QUT-Motorsport/QUTMS_Shutdown/(notices)

Notices in the files:
hardware/CAD/CVS-03TB/CVS-03TB.stp:
FILE_NAME( 'p:/temp/worker_18/temp/exporttempdir_2588_1966_tZlxv/format_0/CVS-03TB.stp', '2021-01-05T11:34:36', ( 'License CC BY-ND 4.0' ), ( 'CADENAS' ), ' ', 'PARTsolutions', ' ' );
